dpradovillar/Eli-Batt/Hardware/master/MegaMiniPinoutRef2.pdf

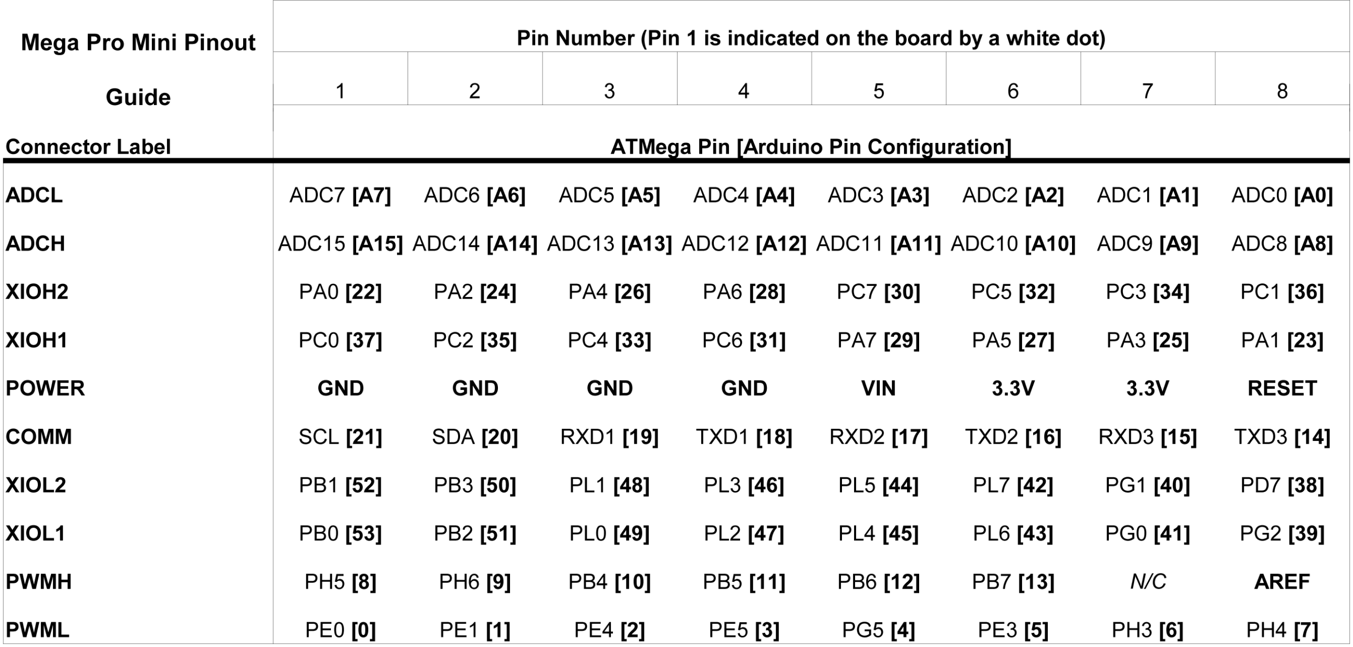
[picture p1: page 1]
