dpradovillar/Eli-Batt/Hardware/master/eagleUp/eagleU01.png

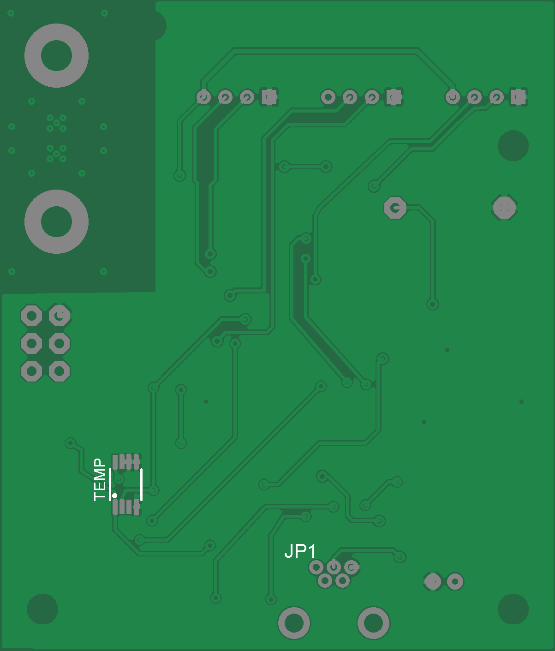
Hardware/master/eagleUp/eagleU01.png
