dpradovillar/Eli-Batt/Hardware/master/eagleUp/eagleUp_.png

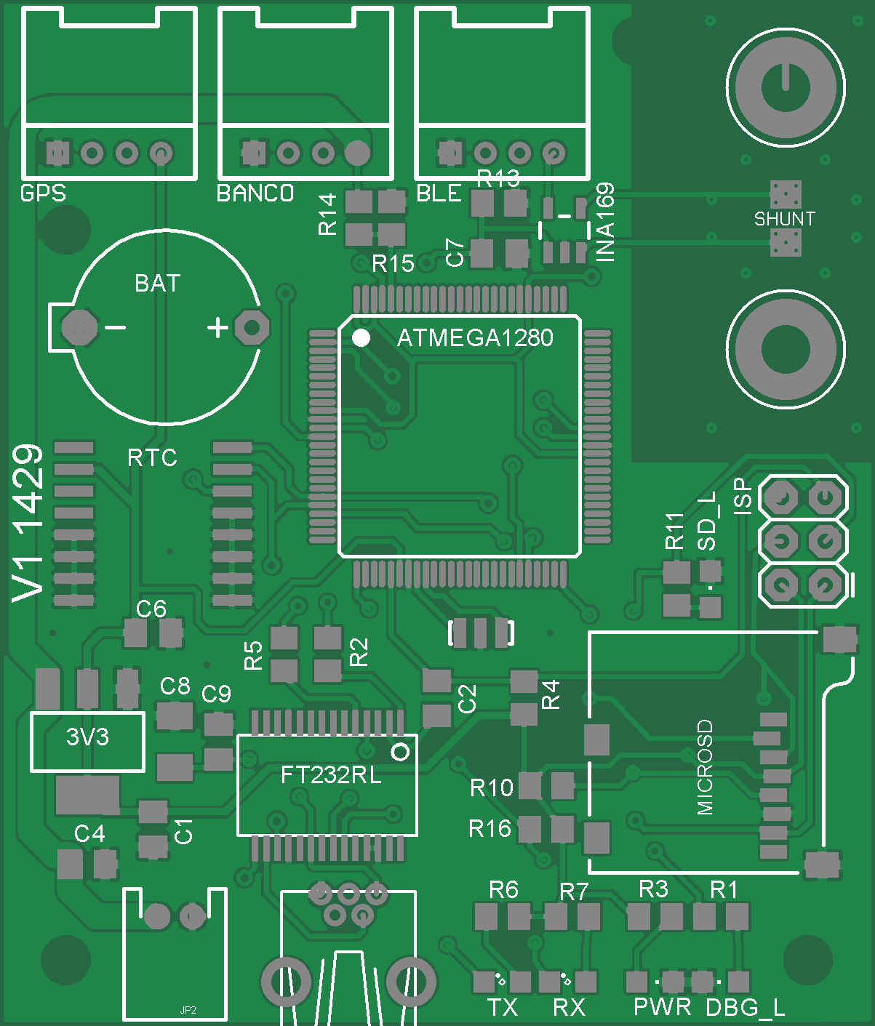
Hardware/master/eagleUp/eagleUp_.png
