dpradovillar/Eli-Batt/Hardware/master/eagleUp/eagleUp_master-v10_board_top.png

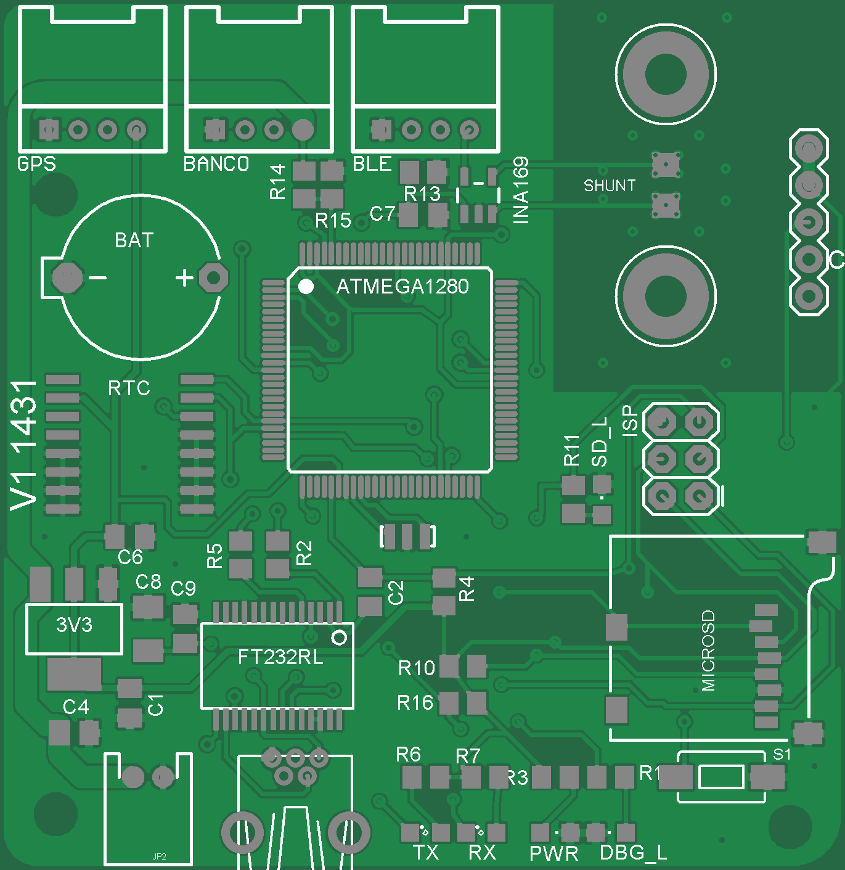
Hardware/master/eagleUp/eagleUp_master-v10_board_top.png
