dpradovillar/Eli-Batt/Hardware/master/eagleUp/eagleUp_master-v10_bottom.png

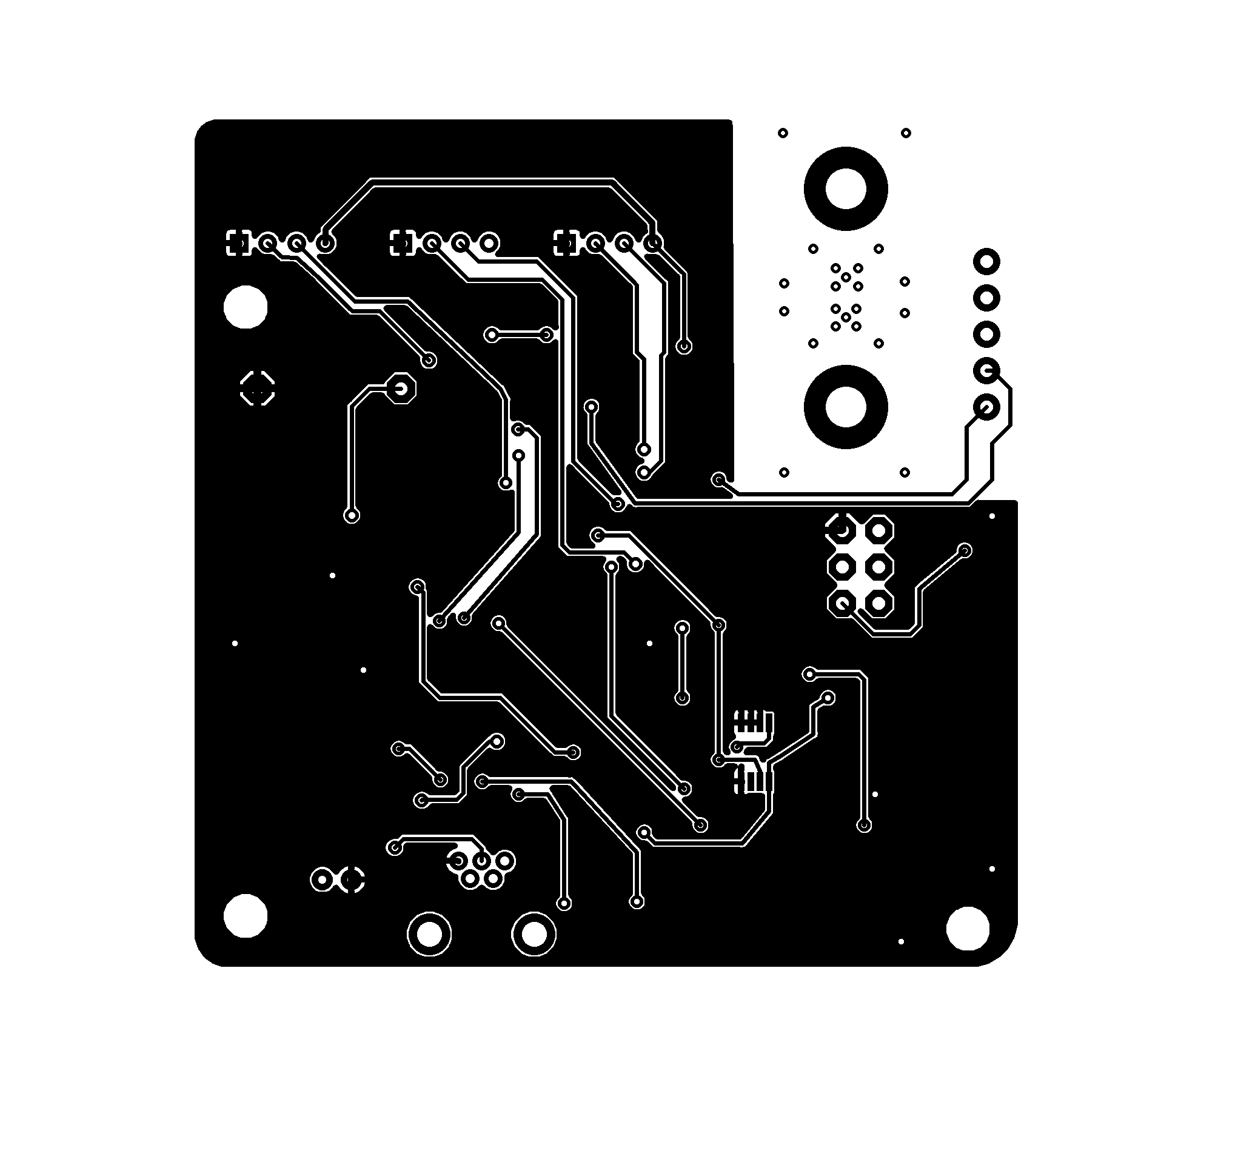
Hardware/master/eagleUp/eagleUp_master-v10_bottom.png
