dpradovillar/Eli-Batt/Hardware/master/eagleUp/eagleUp_master-v10_bottom_mask.png

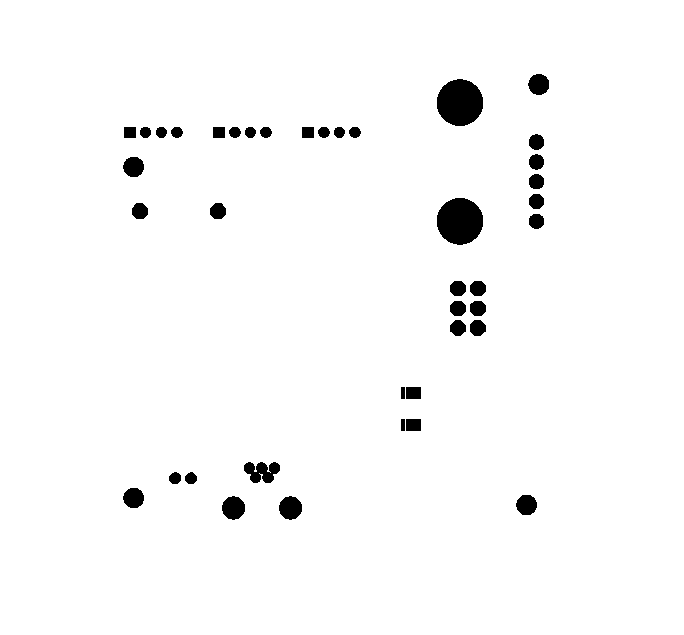
Hardware/master/eagleUp/eagleUp_master-v10_bottom_mask.png
