dpradovillar/Eli-Batt/Hardware/master/eagleUp/eagleUp_master-v10_imagesize.png

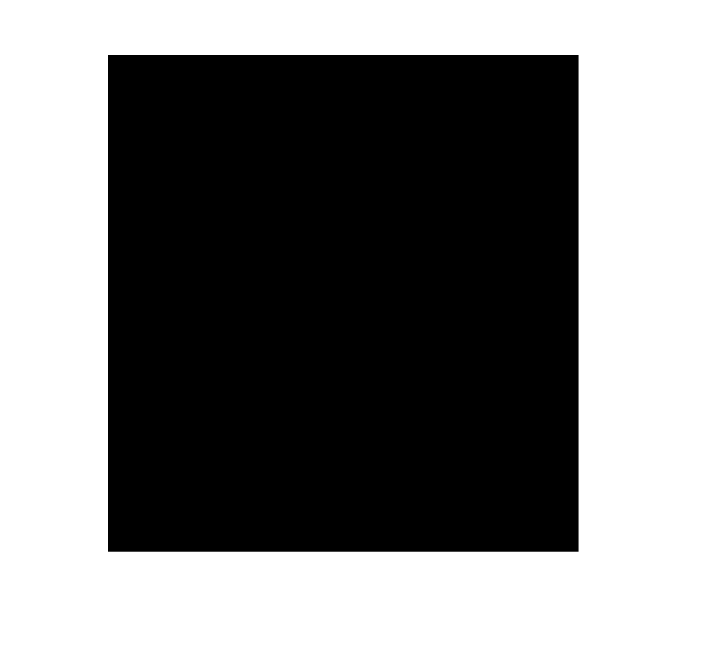
Hardware/master/eagleUp/eagleUp_master-v10_imagesize.png
