dpradovillar/Eli-Batt/Hardware/master/eagleUp/eagleUp_master-v10_outline.png

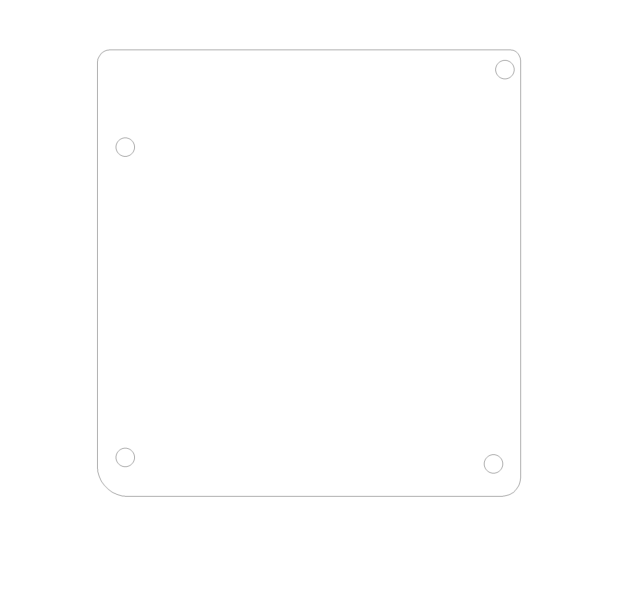
Hardware/master/eagleUp/eagleUp_master-v10_outline.png
