dpradovillar/Eli-Batt/Hardware/master/eagleUp/eagleUp_master-v10_top_mask.png

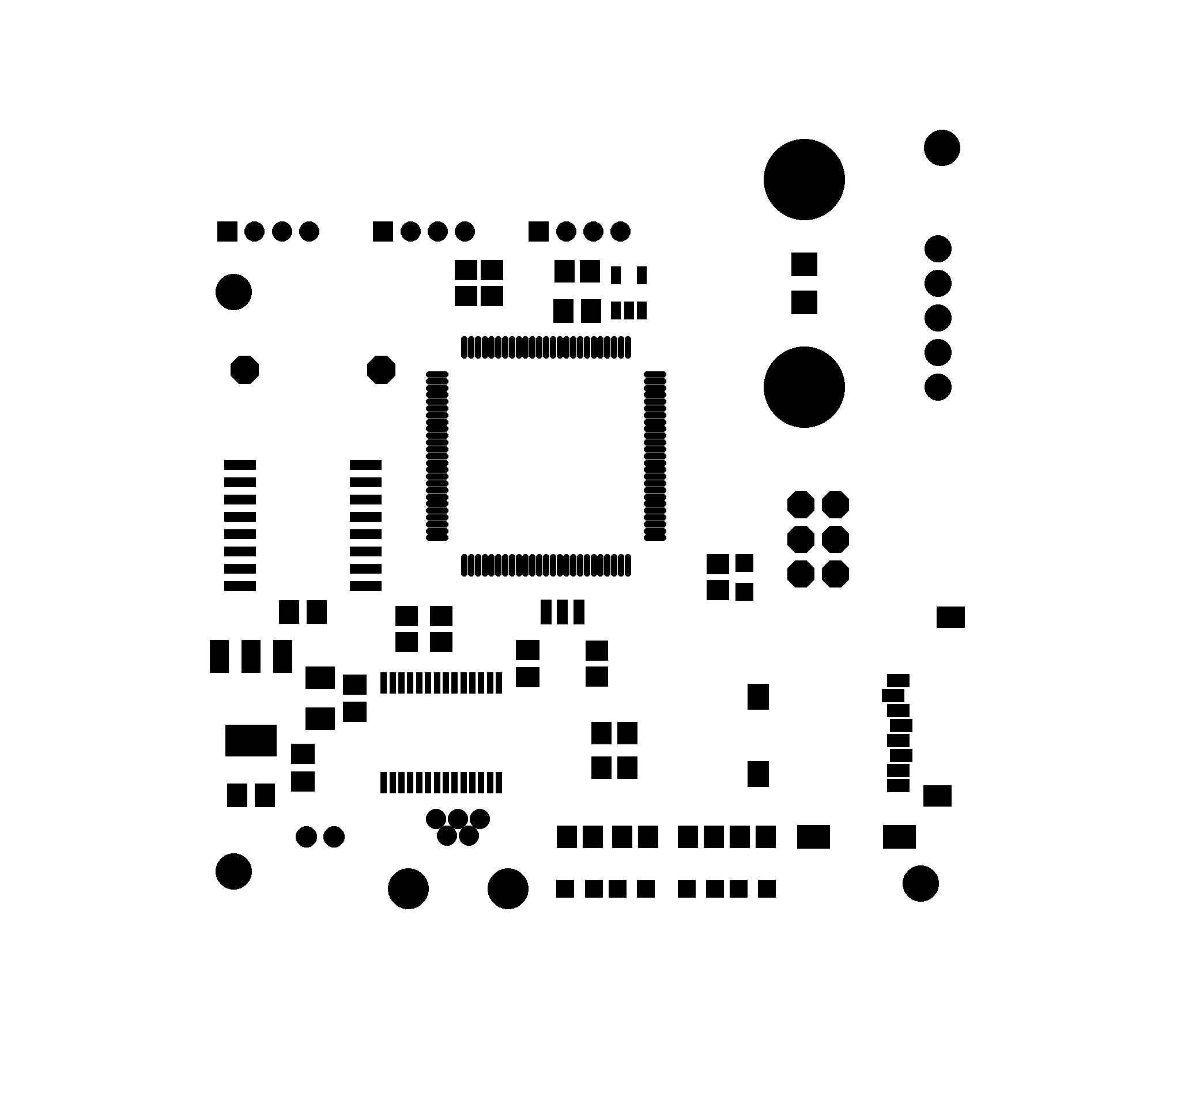
Hardware/master/eagleUp/eagleUp_master-v10_top_mask.png
