dpradovillar/Eli-Batt/Hardware/master/eagleUp/eagleUp_master-v10_top_silk.png

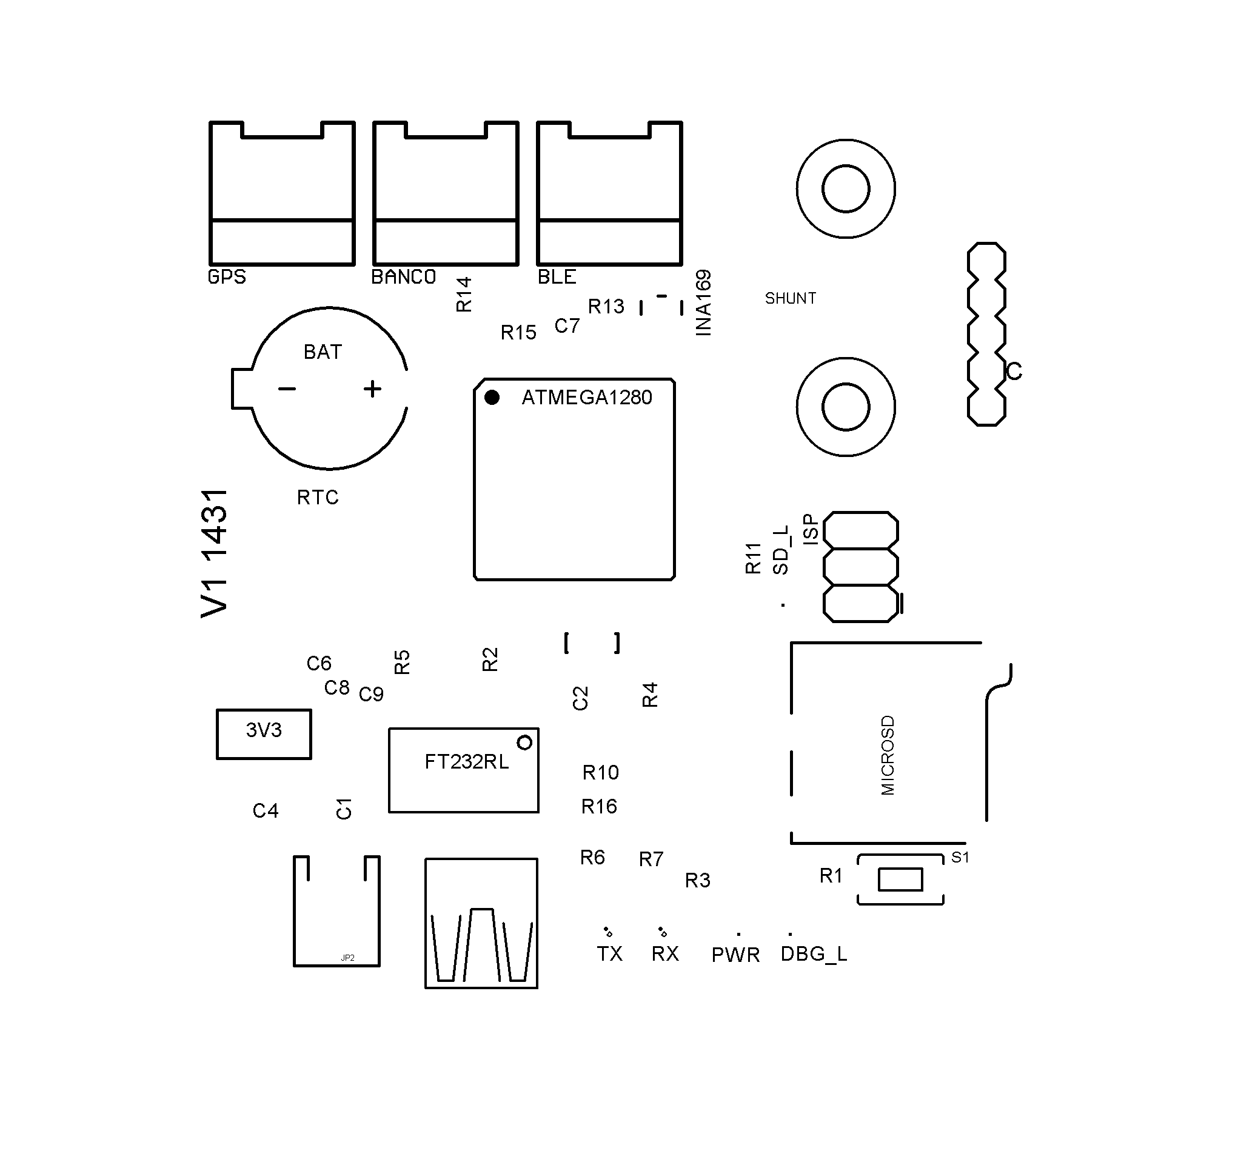
Hardware/master/eagleUp/eagleUp_master-v10_top_silk.png
