dpradovillar/Eli-Batt/Hardware/master/eagleUp/eagleUp_master-v11_board_bottom.png

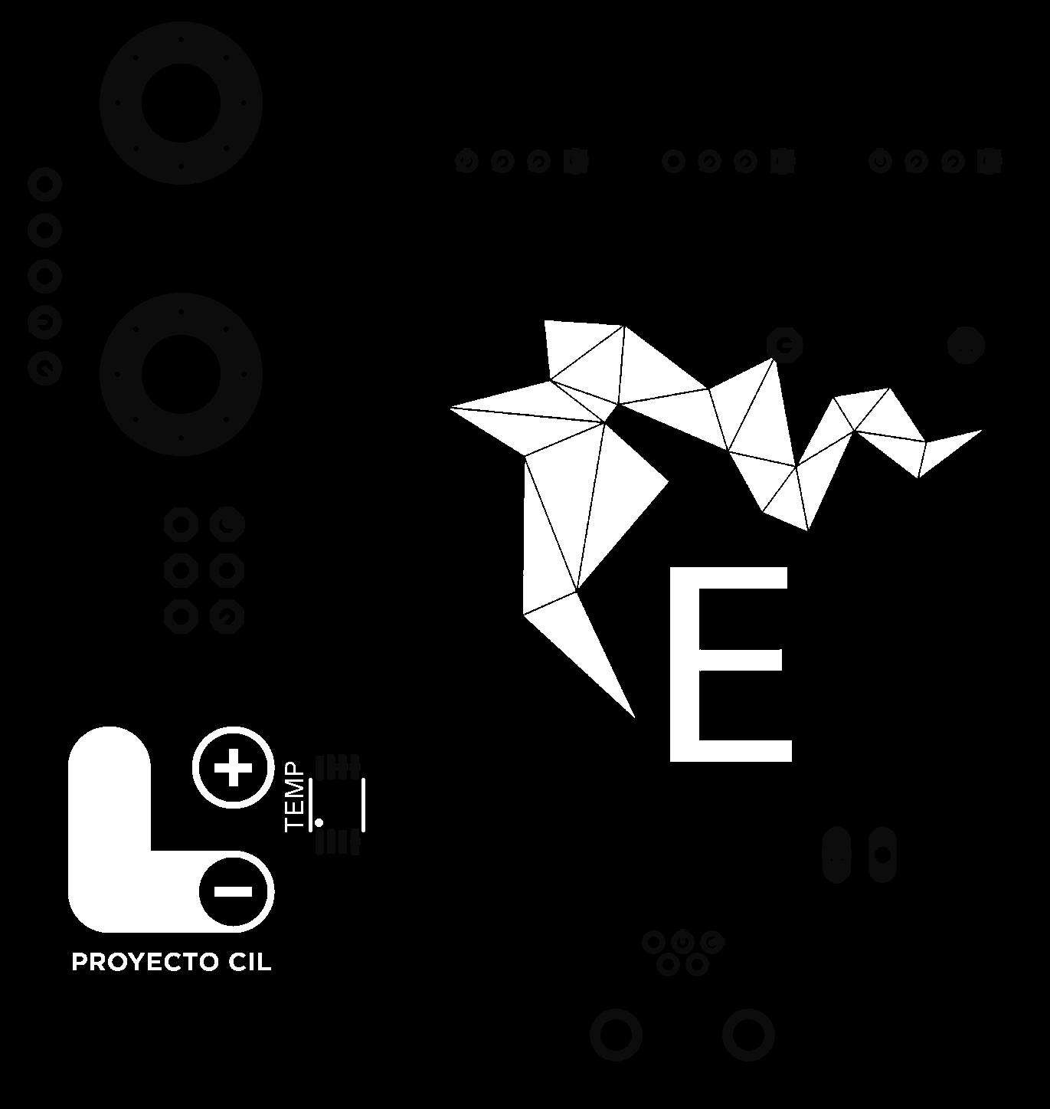
Hardware/master/eagleUp/eagleUp_master-v11_board_bottom.png
