dpradovillar/Eli-Batt/Hardware/master/eagleUp/eagleUp_master-v11_bottom_silk.png

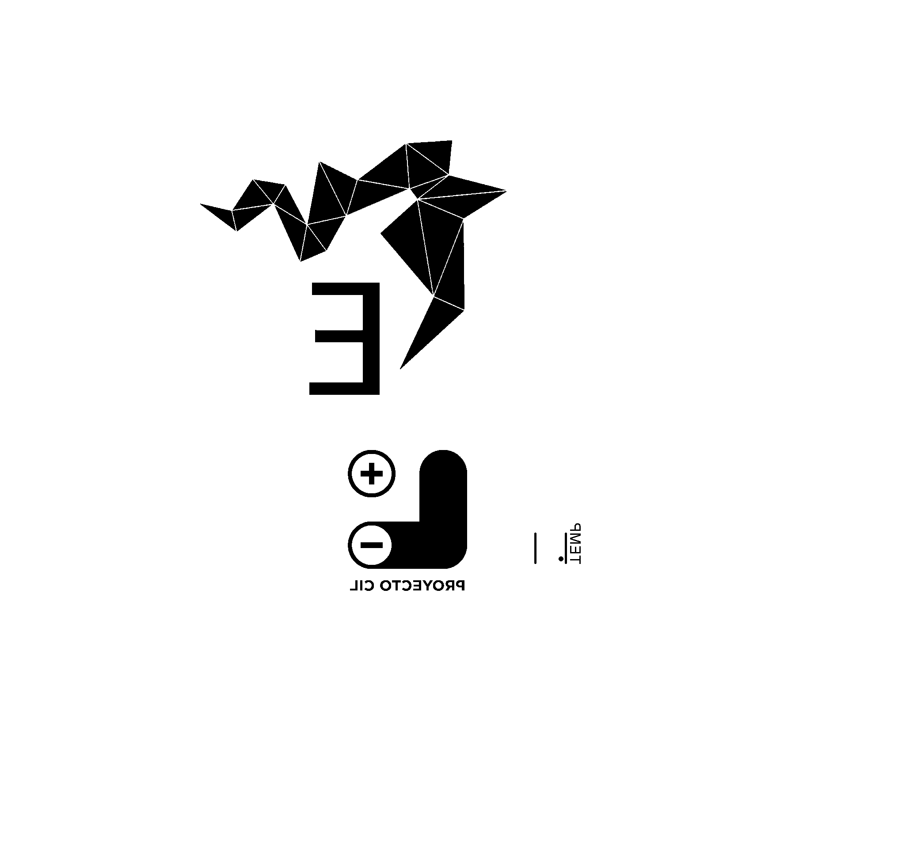
Hardware/master/eagleUp/eagleUp_master-v11_bottom_silk.png
