dpradovillar/Eli-Batt/Hardware/master/eagleUp/eagleUp_master-v11_top.png

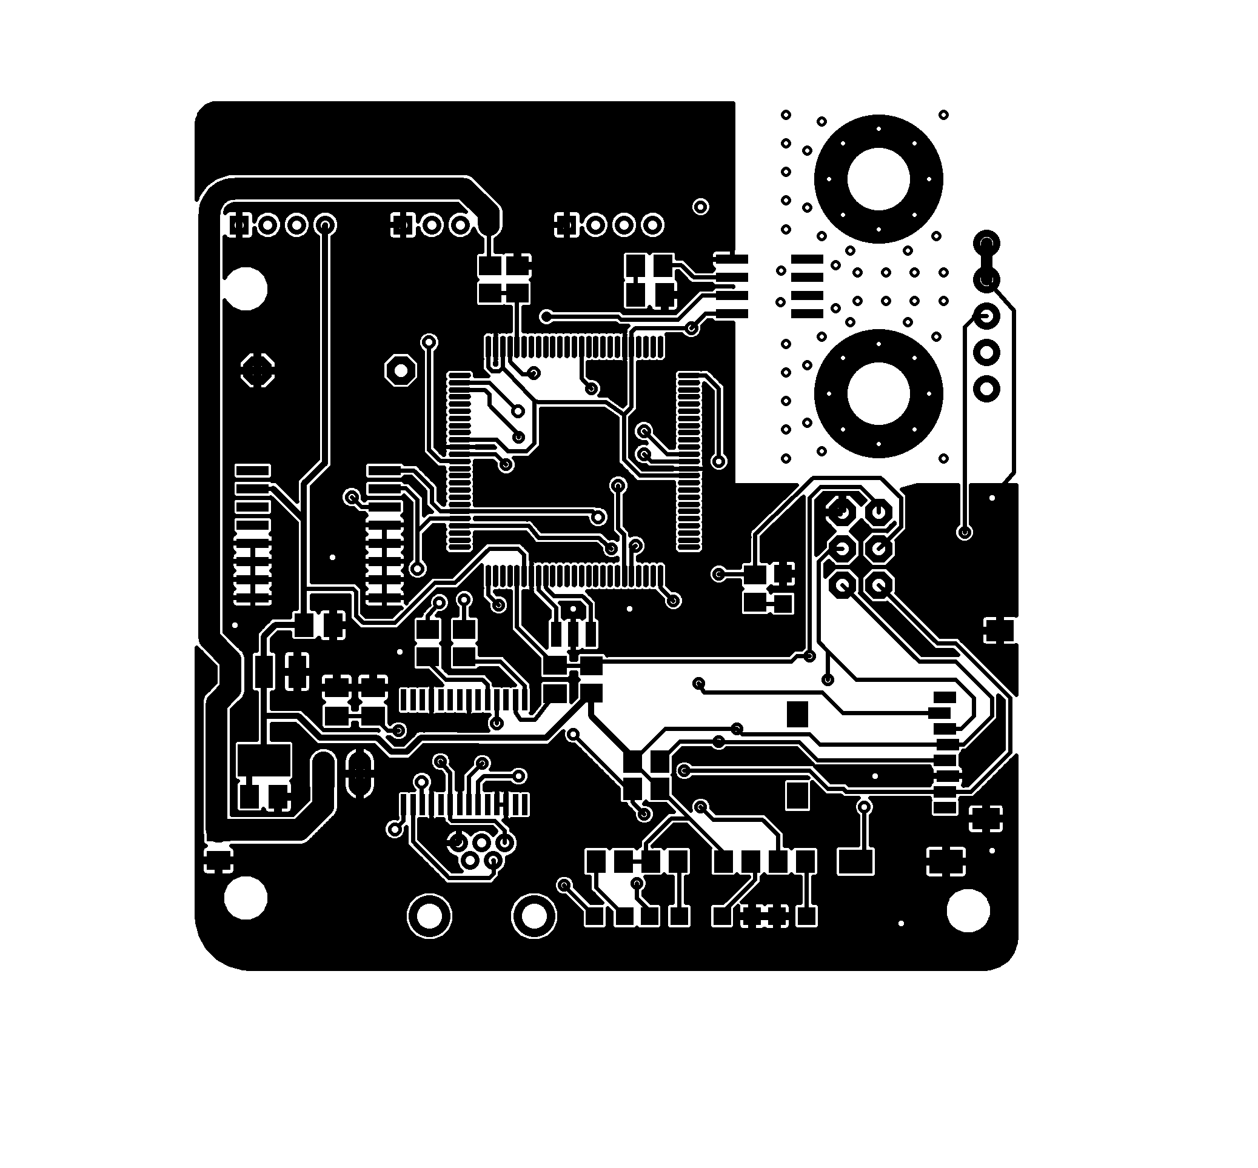
Hardware/master/eagleUp/eagleUp_master-v11_top.png
