dpradovillar/Eli-Batt/Hardware/master/eagleUp/eagleUp_master-v11_top_mask.png

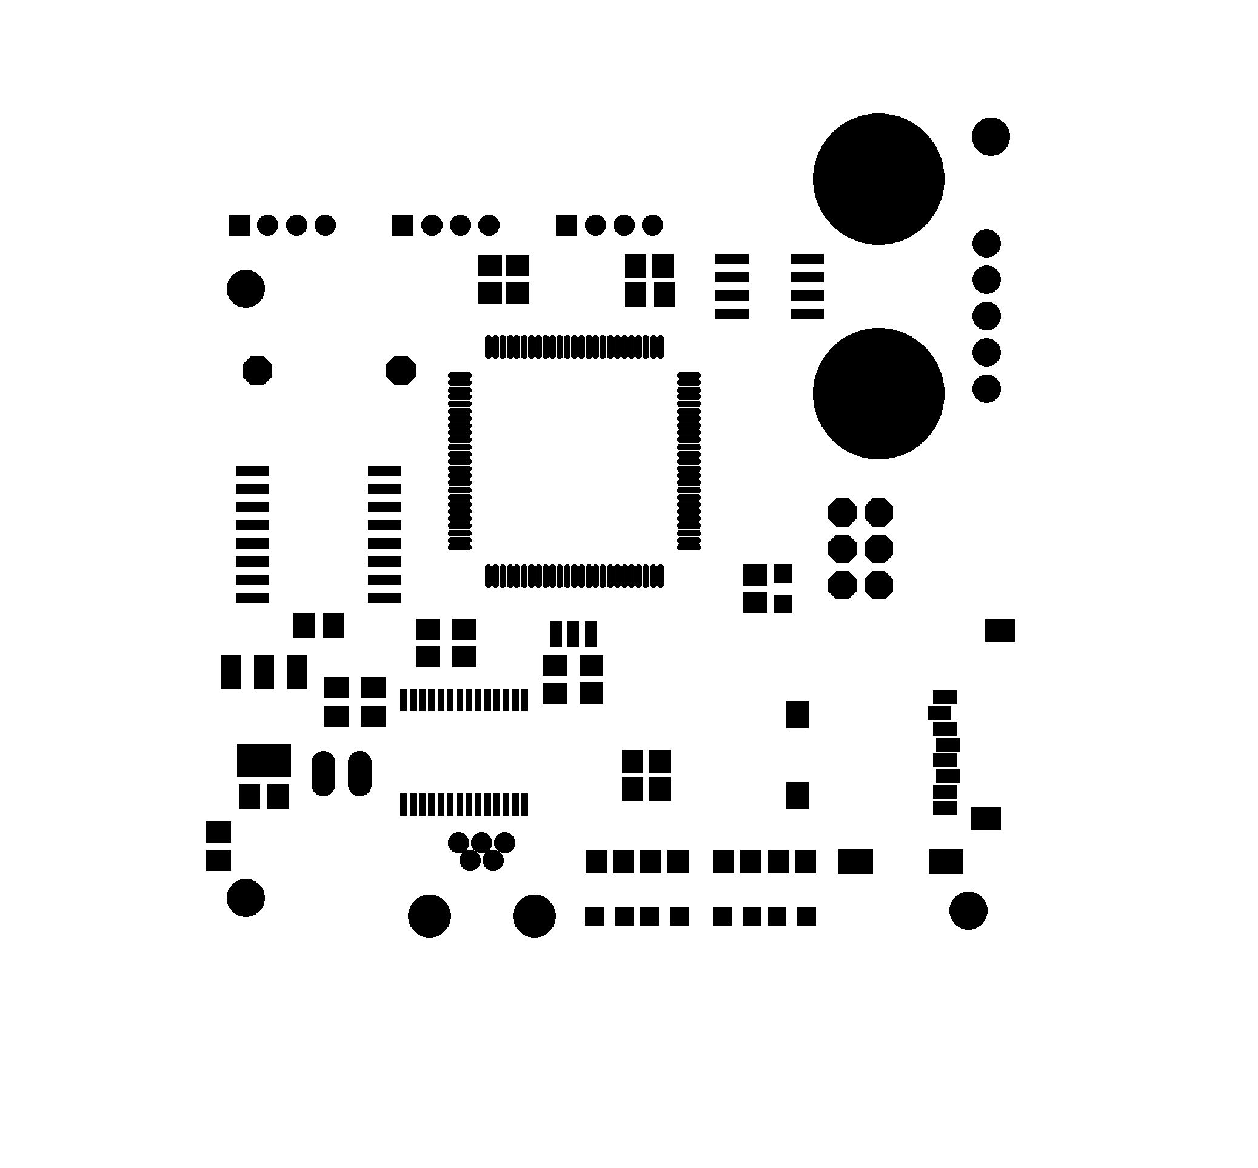
Hardware/master/eagleUp/eagleUp_master-v11_top_mask.png
