dpradovillar/Eli-Batt/Hardware/master/Schematics/ATMEGA1280.jpg

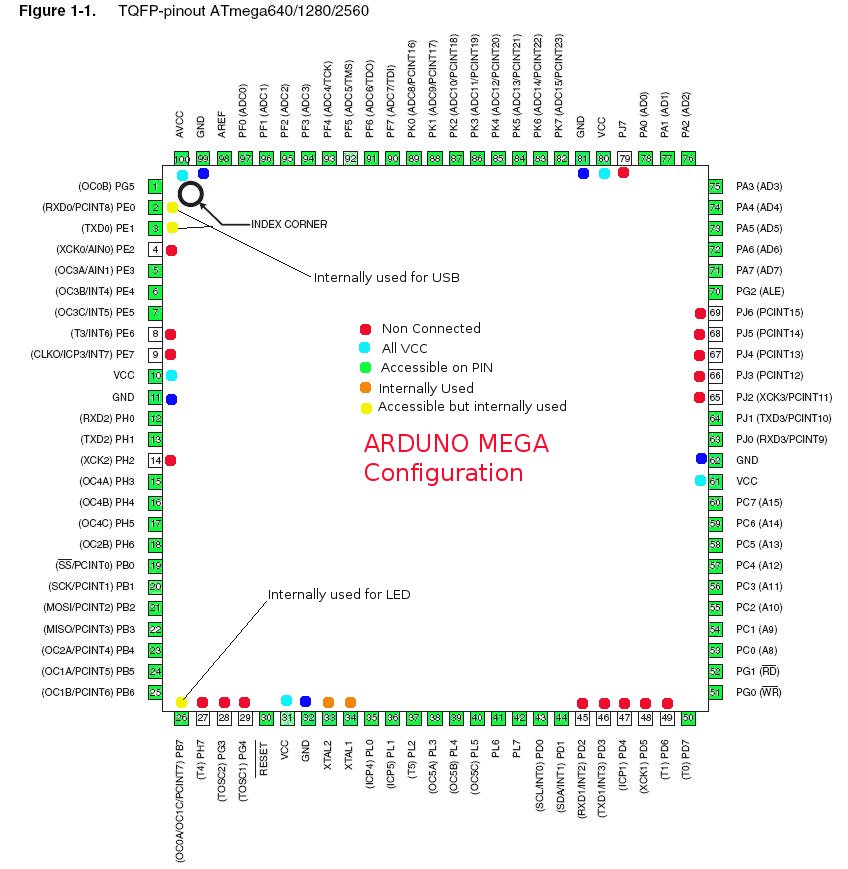
Hardware/master/Schematics/ATMEGA1280.jpg
