dpradovillar/Eli-Batt/Hardware/master/Schematics/Master.png

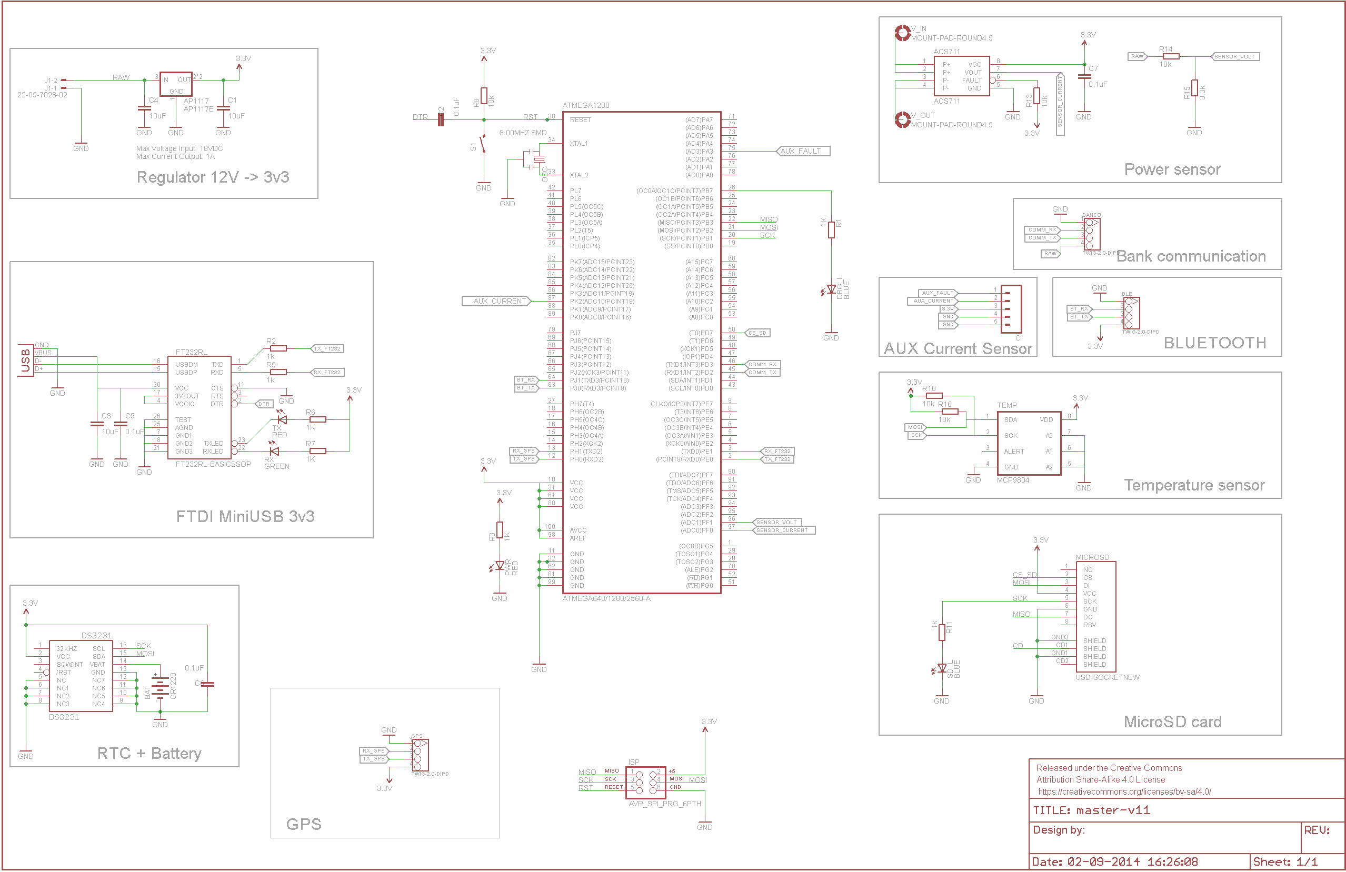
Hardware/master/Schematics/Master.png
