dpradovillar/Eli-Batt/Manufactura/BOM-master-v11.xlsx

Sheet: BOM-master-v11
Qty | Value | Device | Package | Parts | Description | Price | Total Price | Link
4 | 0.1uF | C-EUC0805K | C0805K | C2, C6, C7, C9 | CAPACITOR, European symbol | $0.10 | $0.40 | http://www.digikey.com/product-detail/en/CL21F104ZBCNNNC/1276-1007-1-ND/3889093
4 | 10k | R-EU_R0805 | R0805 | R8, R10, R14, R16 | RESISTOR, European symbol | $0.03 | $0.12 | http://www.digikey.com/product-detail/en/RMCF0805JT10K0/RMCF0805JT10K0CT-ND/1942577
3 | 10uF | C-EUC0805K | C0805K | C1, C3, C4 | CAPACITOR, European symbol | $0.16 | $0.48 | http://www.digikey.com/product-detail/en/CC0805ZKY5V6BB106/311-1355-1-ND/2103139
8 | 1K | R-EU_R0805 | R0805 | R1, R3, R6, R7, R2, R5, R11, R13 | RESISTOR, European symbol | $0.10 | $0.80 | http://www.digikey.com/product-detail/en/RC0805JR-071KL/311-1.0KARCT-ND/731165
1 | J1 | J1 | J1 | J1 | CONN HEADER 2POS .100 R/A TIN | $0.32 | $0.32 | http://www.digikey.com/product-detail/en/0022053021/WM4300-ND/26689
2 | Crimp | Crimp | Crimp | Crimp | CONN TERM CRIMP 22-30 AWG GOLD | $0.64 | $1.28 | http://www.digikey.com/product-detail/en/0008550130/WM9728CT-ND/4037904
1 | Conector | Conector | Conector | Conector | CONN HOUSING 2POS .100 W/RAMP | $0.11 | $0.11 | http://www.digikey.com/product-detail/en/0022012027/WM2011-ND/171991
1 | 3.3k | R-EU_R0805 | R0805 | R15 | RESISTOR, European symbol | $0.63 | $0.63 | http://www.digikey.com/product-detail/en/ERA-6AEB332V/P3.3KDACT-ND/1465959
1 | 8.00MHZ SMD | RESONATOR-SMD | RESONATOR-SMD | OSC | Resonator | $0.46 | $0.46 | http://www.digikey.com/product-detail/en/CSTCE8M00G55-R0/490-1195-1-ND/584632
1 | ACS711 | ACS711 | SOIC8 | ACS711 | Hall-effect-based isolated linear current sensor | $3.05 | $3.05 | http://www.digikey.com/product-detail/en/ACS711KLCTR-25AB-T/620-1373-1-ND/2470587
1 | AP1117E | AP1117E | SOT223 | 3V3 | LDO Regulator | $0.41 | $0.41 | http://www.digikey.com/product-detail/en/AP1117IE33G-13/AP1117IE33G-13DICT-ND/3677984
1 | ATMEGA1280 | ATMEGA1280 | TQFP100A | ATMEGA1280 | MICROCONTROLLER | $15.68 | $15.68 | http://www.digikey.com/product-detail/en/ATMEGA1280-16AUR/ATMEGA1280-16AURCT-ND/3789418
2 | BLUE | LEDCHIPLED_0805 | CHIPLED_0805 | DBG_L, SD_L | LED | $0.44 | $0.88 | http://www.digikey.com/product-detail/en/LTST-C171TBKT/160-1645-1-ND/573585
1 | CR1220 | CR1220 | CR1220 | BAT | LI BATTERY Panasonic | $1.20 | $1.20 | http://www.digikey.com/product-detail/en/CR-1220%2FHFN/P244-ND/965114
1 | DS3231/SO | DS3231 | SO16W | RTC |  | $8.41 | $8.41 | http://www.digikey.com/product-detail/en/DS3231SN%23T%26R/DS3231SN%23T%26RCT-ND/3894827
1 | FT232RL-BASICSSOP | FT232RL | SSOP28DB | FT232RL | USB UART | $4.50 | $4.50 | http://www.digikey.com/product-detail/en/FT232RL-REEL/768-1007-1-ND/1836402
1 | GREEN | LEDCHIPLED_0805 | CHIPLED_0805 | RX | LED | $0.08 | $0.08 | http://www.digikey.com/product-detail/en/LG%20R971-KN-1/475-1410-1-ND/1802598
1 | MCP9804 | MCP9804 | MSOP8 | TEMP | TEMP SENSOR | $1.36 | $1.36 | http://www.digikey.com/product-detail/en/MCP9808-E%2FMS/MCP9808-E%2FMS-ND/2802083
2 | RED | LEDCHIPLED_0805 | CHIPLED_0805 | PWR, TX | LED | $0.08 | $0.16 | http://www.digikey.com/product-detail/en/LH%20R974-LP-1/475-1415-1-ND/1802604
1 | MOMENTARY-2-SMD | SWITCH | TACTILE-SWITCH-1101NE | S1 | Various NO switches- pushbuttons, reed, etc | $0.07 | $0.07 | http://imall.iteadstudio.com/electronic-components/button-and-switch/im120731002.html
3 | TWIG-2.0-DIPD | TWIG-2.0-DIPD | 2.0_1X4_90 | BANCO, BLE, GPS |  | $0.10 | $0.30 | http://www.seeedstudio.com/depot/Grove-Universal-4-pin-connector-9010-PCs-p-790.html
1 | USB-MB-H | USB-MB-H | USB-MB-H | JP1 | USB Connectors | $2.28 | $2.28 | http://www.digikey.com/product-detail/en/0565790519/WM17121-ND/857607
1 | USD-SOCKETNEW | USD-SOCKETNEW | MICRO-SD-SOCKET-PP | MICROSD | microSD Socket | $1.82 | $1.82 | http://www.digikey.com/product-detail/en/101-00660-68-6/101-00660-68-6-1-ND/2187099
 |  |  |  |  |  | TOTAL | $44.80

Sheet: CIL stock
Qty | Value | Device | Package | Parts | Description | Price | Total Price | Link
16 |  | SOC |  |  | SOC RV1.1
6 |  | 4 pin connector |  |  | Grove-Universal 4Pin 90°
1 |  | BLE |  |  | Bluetooth smart 4.0 Mini
5 |  | GPS |  |  | Crius Neo-6 GPS
1 |  | GPS |  |  | g.top013
2 |  | USB Bluetooth dongle |  |  | USB Bluetooth dongle
6 |  | 4 pin connector |  |  | Grove-Universal 4Pin
1 |  | AVR Programer |  |  | Pocket AVR Programer
2 |  | Temp Sensor |  |  | TEMP SENSOR MCP9808-40 a +125°C
2 |  | RTC |  |  | RTC ChronoDot V2.1
3 |  | Mini USB Breakout |  |  | Mini USB Breakout Sparkfun
2 |  | Micro SD Breakout Boeard |  |  | Micro SD Breakout Boeard Sparkfun
2 |  | Microcontroller Mega Pro |  |  | Atmega 2560V Shield
18 |  | Pulsadores |  |  | 6 Pin- Pulsadores
16 |  | 2Pin Screw terminal block |  |  | 2Pin Screw terminal block 3.5mm
7 |  | Current sensor |  |  | ACS711EX -15.5 a +15.5 Amps (Item 2452)
2 |  | Current sensor |  |  | ACS709 -75 a +75 Amps (Item 2199)
5 |  | Microcontroller ATMega 328 |  |  | Microcontroller ATMega 328 bootloader UNO
3 |  | Battery CR 1220 |  |  | Lithium Coin 3V CR-1220
2 |  | Switch |  |  | 6.5 A / 250V
3 |  | Switch Tactile |  |  | Switch Tactile 0.05A / 12V
12 |  | Capacitor |  |  | Cap. Cer. 0.1 Uf 50V 0805
10 |  | Capacitor |  |  | Cap. Cer. 10 Uf 50V 0805
3 |  | Current sensor |  |  | ACS711 25 Amps
3 |  | 3.3V LDO Regulator |  |  | AP1117E
3 |  | Microcontroller ATMega 1280 |  |  | Microcontroller ATMega 1280 128KB flash 100TQFP
3 |  | RTC |  |  | IC RTC CLK/Calendar 12C 16-SOIC DS3231
3 |  | FT232RL |  |  | USB FS serial UART 28-SSOP
6 |  | LED Blue |  |  | Blue LED 0805
3 |  | LED Green |  |  | Green LED 0805
6 |  | LED Red |  |  | Red LED 0805
3 |  | Antena GPS |  |  | Cab. 718 20cm
1 |  | Antena GPS |  |  | Cab. 011 10cm
3 |  | Conn Header |  |  | Conn Header 2 pos. R/A tin
3 |  | Conn USB |  |  | Conn USB 5 pos
3 |  | Conn Micro SD |  |  | Conn Micro SD 8 pin PCB Gold
3 |  | Resonator |  |  | Cer. Resonator 8Mhz SMD
35 |  | Resistors |  |  | Res. 1K ohm 1/8W 0805
12 |  | Resistors |  |  | Res. 10K ohm 1/8W 0805
19 |  | Resistors |  |  | Res. 3.3K ohm 1/8W 0805
2 |  | porta fusible
11 |  | cables |  |  | 8 pin fem.
