dpradovillar/Eli-Batt/Hardware/master/Schematics/Leonardino_parts_list.xls

Atmega32U4_H49xtal_uSD_RevA.5.sch |  | Manufacturer P/N | Digikey PN
Part Value Device Package Library Sheet
+3V +3V SJ SJ jumper 1
C1 22p C-EUC0805K C0805K rcl 1 | 22pFnF, 0805 | GRM2195C2A220JZ01D | 490-1591-2-ND
C10 100n C-EUC0805K C0805K rcl 1 | 100nF, 0805 | C0805C104K3RACTU | 399-1168-1-ND
C11 100n C-EUC0805K C0805K rcl 1 | 100nF, 0805 | C0805C104K3RACTU | 399-1168-1-ND
C3 22p C-EUC0805K C0805K rcl 1 | 22pFF, 0805 | GRM2195C2A220JZ01D | 490-1591-2-ND
C4 100n C-EUC0805K C0805K rcl 1 | 100nF, 0805 | C0805C104K3RACTU | 399-1168-1-ND
C5 100n C-EUC0805K C0805K rcl 1 | 100nF, 0805 | C0805C104K3RACTU | 399-1168-1-ND
C6 100n C-EUC0805K C0805K rcl 1 | 100nF, 0805 | C0805C104K3RACTU | 399-1168-1-ND
C12 1uF C-EUC0805K C0805K rcl 1 | 1uF, 0805 | GRM216R61E105KA12D | 490-1700-2-ND
C2 1uF C-EUC0805K C0805K rcl 1 | 1uF, 0805 | GRM216R61E105KA12D | 490-1700-2-ND
C7 1uF C-EUC0805K C0805K rcl 1 | 1uF, 0805 | GRM216R61E105KA12D | 490-1700-2-ND
C8 1uF C-EUC0805K C0805K rcl 1 | 1uF, 0805 | GRM216R61E105KA12D | 490-1700-2-ND
C9 1uF C-EUC0805K C0805K rcl 1 | 1uF, 0805 | GRM216R61E105KA12D | 490-1700-2-ND
F1 500mA L-EUL1812 L1812 rcl 1 | polyfuse | 1812L075PR | F2151CT-ND
IC1 MCP1703DB MCP1703DB SOT223 linear 1 | MCP1703DB | MCP1703-3302E/DB | MCP1703-3302E/DB-ND
IC4 SN74LVC125ADR SN74LVC125ADR TSSOP14 74xx-us 1 | SN74LVC125ADR | SN74LVC125ADR | 296-8453-1-ND
JP1 M06SIP 1X06 SparkFun 1 | 0.025", 0.1" pitch header pins
JP3 M06SIP 1X06 SparkFun 1 | header pins
JP4 M06SIP 1X06 SparkFun 1 | header pins
JP6 M06SIP 1X06 SparkFun 1 | header pins
JP7 M03PTH 1X03 SparkFun 1 | header pins
JP8 M03PTH 1X03 SparkFun 1 | header pins
JP9 M03PTH 1X03 SparkFun 1 | header pins
JP10 M03PTH 1X03 SparkFun 1 | header pins
VBUS M02PTH 1X02 SparkFun 1 | header pins
VBUS_ M02PTH 1X02 SparkFun 1 | header pins
0.1" x 2 Jumper | qty 2 | 382811-8 | A26228-ND
PWR LEDCHIP-LED0805 CHIP-LED0805 adafruit 1 | LED, 0805 | LG R971-KN-1-0-20-R18 | 475-1410-1-ND
Q1 CRYSTALHC49UP HC49UP crystal 1 | HC49UP, 16 MHz | 9C-16.000MEEJ-T | 887-1274-1-ND
R1 1K R-EU_ R0805RND rcl 1 | 1K, 0805 | RR1220P-102-D | RR12P1.0KDCT-ND
R2 22 R-EU_ R0805RND rcl 1 | 22 ohm, 08085 | RR1220Q-220-D | RR12Q22DCT-ND
R3 22 R-EU_ R0805RND rcl 1 | 22 ohm, 08085 | RR1220Q-220-D | RR12Q22DCT-ND
R4 10k R-EU_ R0805RND rcl 1 | 10K, 0805 | RR1220P-103-D | RR12P10.0KDCT-ND
R5 10k R-EU_ R0805RND rcl 1 | 10K, 0805 | RR1220P-103-D | RR12P10.0KDCT-ND
U4 ATMEGA32U4-AU ATMEGA32U4-AU TQFP44 adafruit 1 | ATMEGA32U4 | ATMEGA32U4-AU | ATMEGA32U4-AU-ND
USD MICROSD_PI MICROSD_PP MICROSD_PITO 1 | MicroSD socket, SM | http://www.dipmicro.com/store/CON-MICROSD1
 |  | MicroSD/TransFlash push/push connector.
X1 USB-MICROB USB-MICROB USB-MICROB SparkFun 1 | Mini-B socket, 5 pin, SM | 1981568-1 | A97800CT-ND
 |  | TE Connectivity
