dpradovillar/Eli-Batt/(list of files, cad)

Other CAD files:
Hardware/master/eagleUp/PCB MASTER Black.skp
Hardware/master/eagleUp/PCB MASTER.skp
