dpradovillar/Eli-Batt/Manufactura/Assembling_reference.jpg

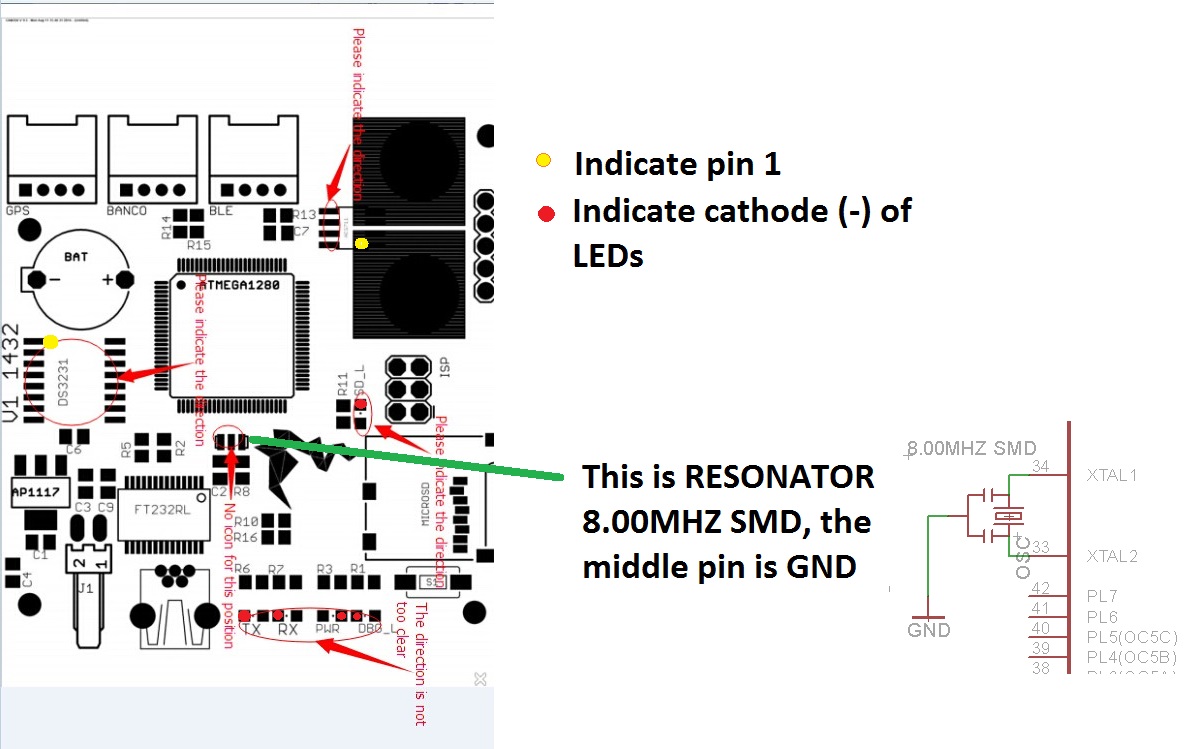
Manufactura/Assembling_reference.jpg
