dpradovillar/Eli-Batt/Software/Elibatt-Viewer/data/data.pdf

# Reporte E-LiBatt

## Temperatura (C°)

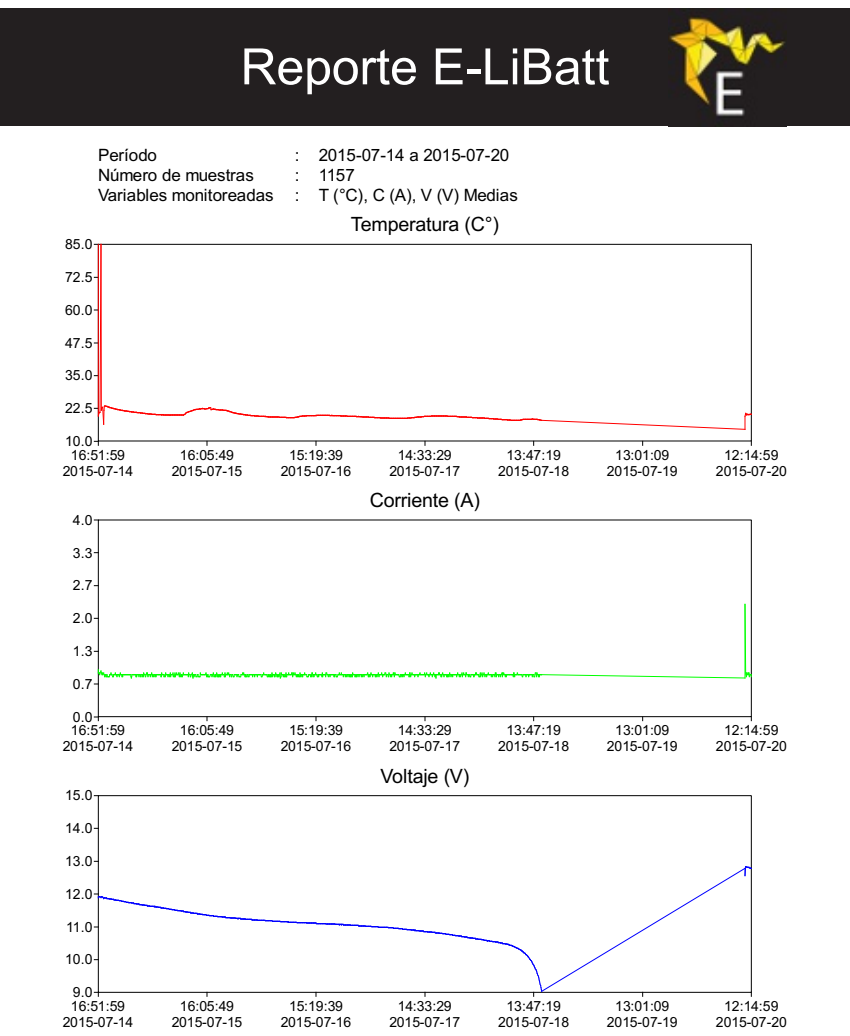
[picture p44: page 1]
2015-07-14 a 2015-07-20 1157 T (°C), C (A), V (V) Medias; Corriente (A); Voltaje (V)

Período
Número de muestras
Variables monitoreadas
