dpradovillar/Eli-Batt/Hardware/slave/Slave-v12.brd

## EAGLE design Hardware/slave/Slave-v12.brd (2015-03-27)

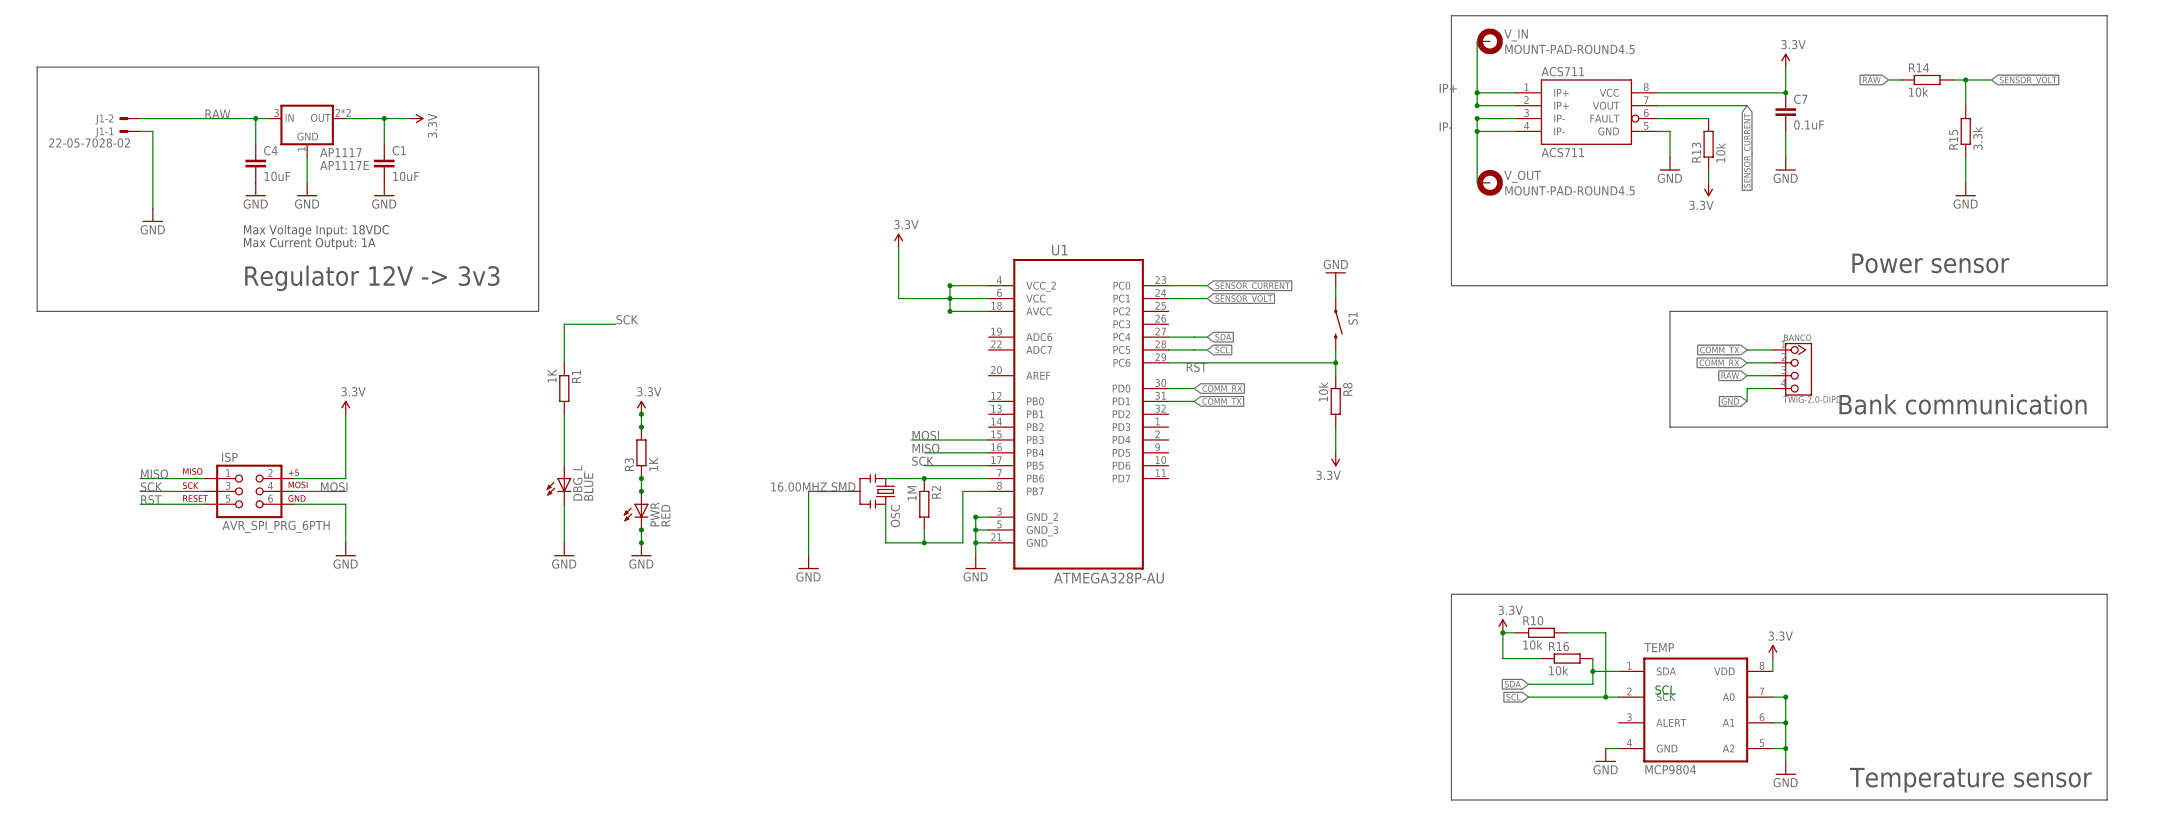
[picture p45: schematic Slave-v12.sch]

Parts:
ACS711: ACS711; SOIC8; MPN ACS711KLCTR-25AB-T
AP1117: AP1117E; SOT223; MPN AP1117E33G-13
BANCO: TWIG-2.0-DIPD; 2.0_1X4_90
C1, C4: 10uF; C0805K; MPN 0805ZD106KAT2A
C7: 0.1uF; C0805K; MPN MC0603B104K500CT
DBG_L: BLUE; CHIPLED_0805; MPN 150080BS75000
ISP: AVR_SPI_PRG_6PTH; 2X3
J1: 22-05-7028-02; 7395-02
OSC: 16.00MHZ SMD; RESONATOR-SMD; MPN PBRC8.00HR50X000
PWR: RED; CHIPLED_0805; MPN KPT-2012SRC-J4
R1, R3: 1K; R0805; MPN CRCW08051K00FKTA
R2: 1M; R0805; MPN CRCW080510K0FKTA
R8, R10, R13, R14, R16: 10k; R0805; MPN CRCW080510K0FKTA
R15: 3.3k; R0805; MPN CRCW08053K30FKTA
S1: SWITCH-MOMENTARY-2-SMD-1101NE; TACTILE-SWITCH-1101NE
TEMP: MCP9804; MSOP8; MPN MCP9808-E/MS
U1: ATMEGA328P-AU; QFP80P900X900X120-32N
V_IN: MOUNT-PAD-ROUND4.5; 4,5-PAD
V_OUT: MOUNT-PAD-ROUND4.5; 4,5-PAD

Connections:
3.3V: ACS711.8 (VCC), C7.1, ISP.2, R3.2, R8.2, R10.1, R13.1, R16.1, TEMP.8 (VDD), U1.4 (VCC_2), U1.6 (VCC), U1.18 (AVCC)
COMM_RX: BANCO.2, U1.30 (PD0)
COMM_TX: BANCO.1, U1.31 (PD1)
GND: ACS711.5 (GND), AP1117.1 (GND), BANCO.4, C1.2, C4.2, C7.2, DBG_L.C, ISP.6, J1.1, OSC.2, PWR.C, R15.1, S1.P$1 (1), TEMP.4 (GND), TEMP.5 (A2), TEMP.6 (A1), TEMP.7 (A0), U1.3 (GND_2), U1.5 (GND_3), U1.21 (GND)
IP+: ACS711.1 (IP+), ACS711.2 (IP+), V_IN.B4,5
IP-: ACS711.3 (IP-), ACS711.4 (IP-), V_OUT.B4,5
MISO: ISP.1, U1.16 (PB4)
MOSI: ISP.4, U1.15 (PB3)
unnamed: OSC.1, R2.1, U1.7 (PB6)
unnamed: DBG_L.A, R1.2
unnamed: PWR.A, R3.1
unnamed: OSC.3, R2.2, U1.8 (PB7)
unnamed: ACS711.6 (FAULT), R13.2
RAW: AP1117.3 (IN), BANCO.3, C4.1, J1.2, R14.1
RST: ISP.5, R8.1, S1.P$2 (2), U1.29 (PC6)
SCK: ISP.3, R1.1, U1.17 (PB5)
SCL: R10.2, TEMP.2 (SCK), U1.28 (PC5)
SDA: R16.2, TEMP.1 (SDA), U1.27 (PC4)
SENSOR_CURRENT: ACS711.7 (VOUT), U1.23 (PC0)
SENSOR_VOLT: R14.2, R15.2, U1.24 (PC1)
VCC: AP1117.2 (OUT), AP1117.4 (OUT), C1.1

Notes on the sheet:
Max Voltage Input: 18VDC
Max Current Output: 1A
Regulator 12V -> 3v3
Power sensor
Temperature sensor
Bank communication
SCL

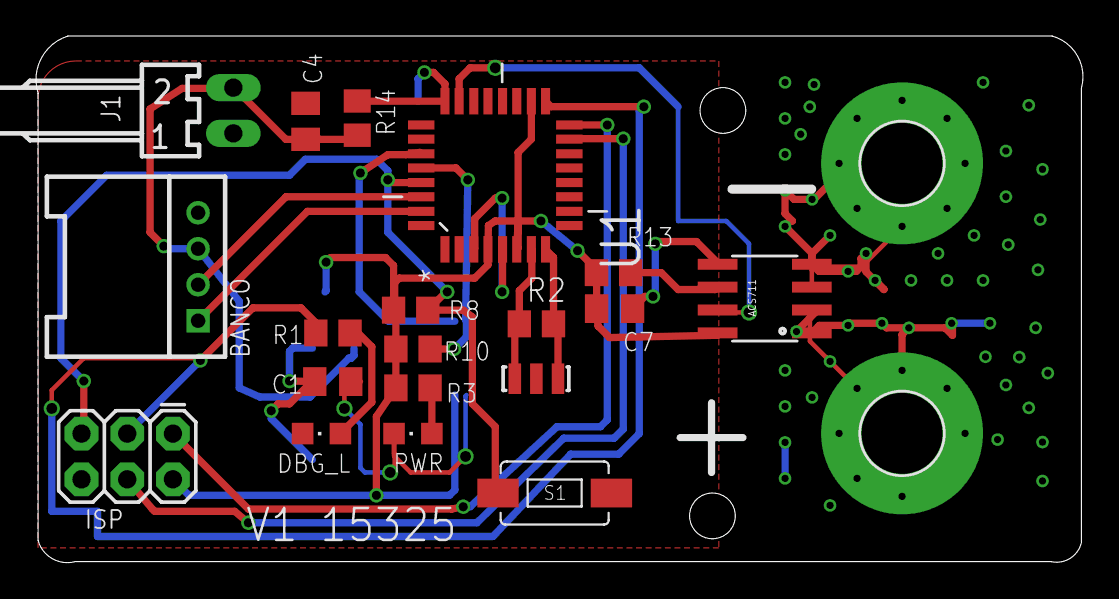
[picture p46: board Slave-v12.brd from above]

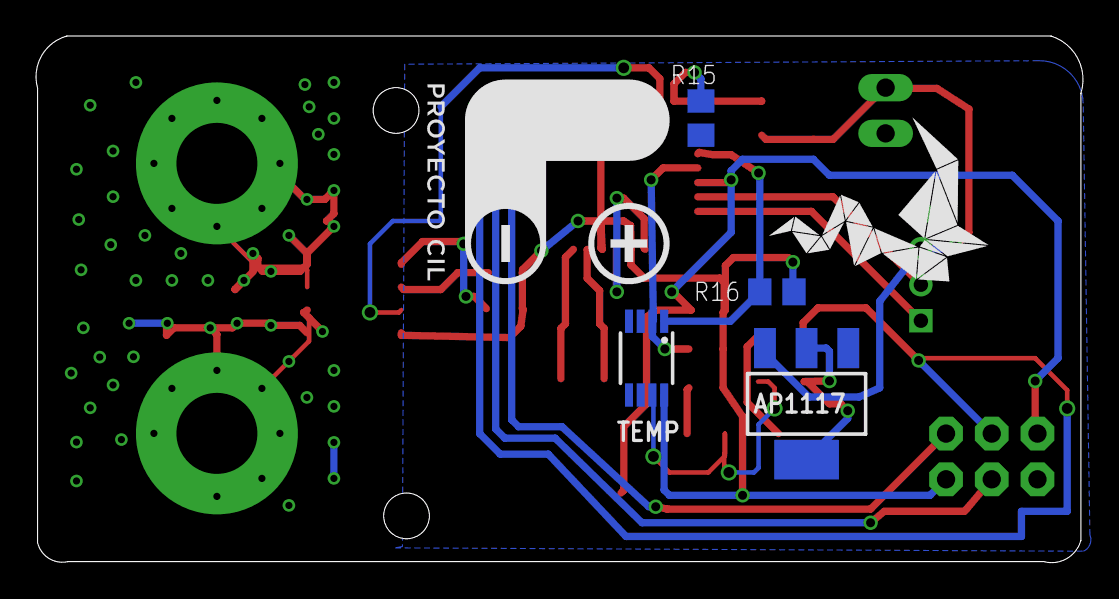
[picture p47: board Slave-v12.brd from below]

Board: 2 copper layers, 58.2 x 29.3 mm, 27 parts (6 on the bottom side), 21 nets.

Other parts of the board:
U$1: LOGO_CIL
U$4: LOGO_ELIBATT2
