dpradovillar/Eli-Batt/Hardware/master/master-v12_36V.brd

## EAGLE design Hardware/master/master-v12_36V.brd (2014-12-18)

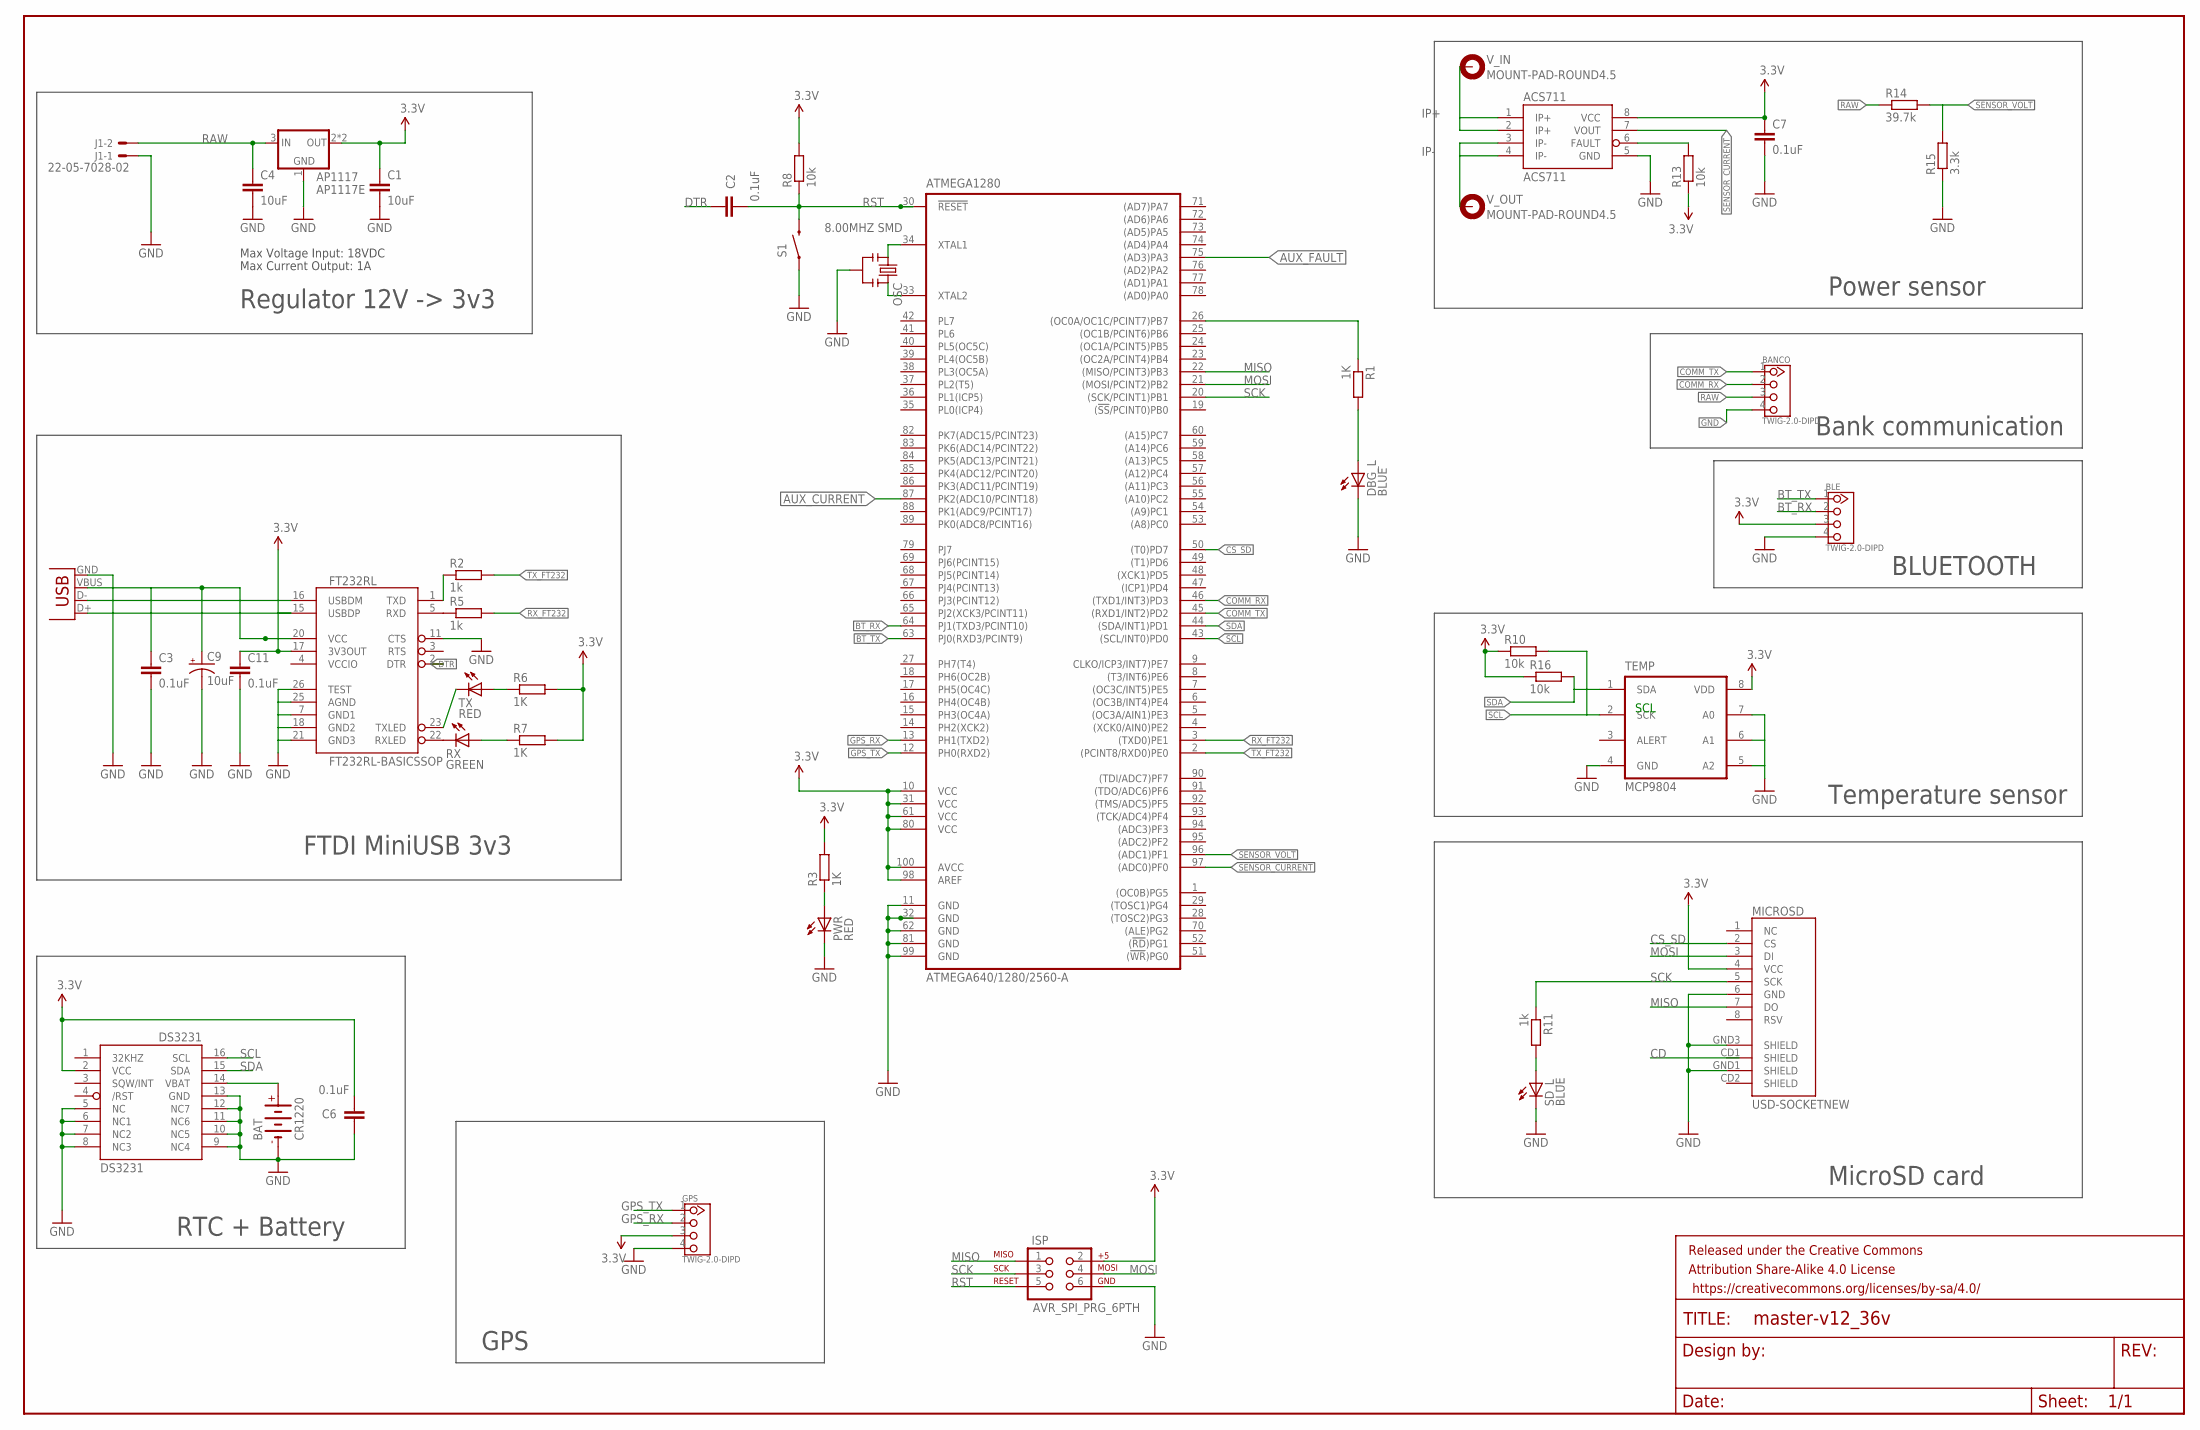
[picture p48: schematic master-v12_36V.sch]

Parts:
ACS711: ACS711; SOIC8
AP1117: AP1117E; SOT223
ATMEGA1280: ATMEGA640/1280/2560-A; TQFP100A
BANCO: TWIG-2.0-DIPD; 2.0_1X4_90
BAT: CR1220
BLE: TWIG-2.0-DIPD; 2.0_1X4_90
C1, C4: 10uF; C0805K
C2, C6, C7: 0.1uF; C0805K
C3, C11: 0.1uF; 0402-CAP
C9: 10uF; EIA3216
DBG_L: BLUE; CHIPLED_0805
DS3231: DS3231/SO; SO16W
FRAME1: FRAME-LEDGER; CREATIVE_COMMONS
FT232RL: FT232RL-BASICSSOP; SSOP28DB
GPS: TWIG-2.0-DIPD; 2.0_1X4_90
ISP: AVR_SPI_PRG_6PTH; 2X3
J1: 22-05-7028-02; 7395-02
MICROSD: USD-SOCKETNEW; MICRO-SD-SOCKET-PP
OSC: 8.00MHZ SMD; RESONATOR-SMD
PWR: RED; CHIPLED_0805
R1, R3, R6, R7: 1K; R0805
R2, R5, R11: 1k; R0805
R8, R10, R13, R16: 10k; R0805
R14: 39.7k; R0805
R15: 3.3k; R0805
RX: GREEN; CHIPLED_0805
S1: SWITCH-MOMENTARY-2-SMD-1101NE; TACTILE-SWITCH-1101NE
SD_L: BLUE; CHIPLED_0805
TEMP: MCP9804; MSOP8
TX: RED; CHIPLED_0805
V_IN: MOUNT-PAD-ROUND4.5; 4,5-PAD
V_OUT: MOUNT-PAD-ROUND4.5; 4,5-PAD
X1: USB-MB-H

Connections:
3.3V: ACS711.8 (VCC), AP1117.2 (OUT), AP1117.4 (OUT), ATMEGA1280.10 (VCC), ATMEGA1280.31 (VCC), ATMEGA1280.61 (VCC), ATMEGA1280.80 (VCC), ATMEGA1280.98 (AREF), ATMEGA1280.100 (AVCC), BLE.3, C1.1, C6.1, C7.1, C11.1, DS3231.2 (VCC), FT232RL.17 (3V3OUT), GPS.3, ISP.2, MICROSD.4 (VCC), R3.2, R6.2, R7.2, R8.2, R10.1, R13.1, R16.1, TEMP.8 (VDD)
AUX_CURRENT: ATMEGA1280.87 (PK2(ADC10/PCINT18))
AUX_FAULT: ATMEGA1280.75 ((AD3)PA3)
BT_RX: ATMEGA1280.64 (PJ1(TXD3/PCINT10)), BLE.2
BT_TX: ATMEGA1280.63 (PJ0(RXD3/PCINT9)), BLE.1
COMM_RX: ATMEGA1280.46 ((TXD1/INT3)PD3), BANCO.2
COMM_TX: ATMEGA1280.45 ((RXD1/INT2)PD2), BANCO.1
CS_SD: ATMEGA1280.50 ((T0)PD7), MICROSD.2 (CS)
DTR: C2.2, FT232RL.2 (DTR)
GND: ACS711.5 (GND), AP1117.1 (GND), ATMEGA1280.11 (GND), ATMEGA1280.32 (GND), ATMEGA1280.62 (GND), ATMEGA1280.81 (GND), ATMEGA1280.99 (GND), BANCO.4, BAT.-, BLE.4, C1.2, C3.2, C4.2, C6.2, C7.2, C9.C (-), C11.2, DBG_L.C, DS3231.5 (NC), DS3231.6 (NC1), DS3231.7 (NC2), DS3231.8 (NC3), DS3231.9 (NC4), DS3231.10 (NC5), DS3231.11 (NC6), DS3231.12 (NC7), DS3231.13 (GND), FT232RL.7 (GND1), FT232RL.11 (CTS), FT232RL.18 (GND2), FT232RL.21 (GND3), FT232RL.25 (AGND), FT232RL.26 (TEST), GPS.4, ISP.6, J1.1, MICROSD.6 (GND), MICROSD.GND1 (SHIELD), MICROSD.GND3 (SHIELD), OSC.2, PWR.C, R15.1, S1.P$1 (1), SD_L.C, TEMP.4 (GND), TEMP.5 (A2), TEMP.6 (A1), TEMP.7 (A0), X1.GND
GPS_RX: ATMEGA1280.13 (PH1(TXD2)), GPS.2
GPS_TX: ATMEGA1280.12 (PH0(RXD2)), GPS.1
IP+: ACS711.1 (IP+), ACS711.2 (IP+), V_IN.B4,5
IP-: ACS711.3 (IP-), ACS711.4 (IP-), V_OUT.B4,5
MISO: ATMEGA1280.22 ((MISO/PCINT3)PB3), ISP.1, MICROSD.7 (DO)
MOSI: ATMEGA1280.21 ((MOSI/PCINT2)PB2), ISP.4, MICROSD.3 (DI)
unnamed: BAT.+, DS3231.14 (VBAT)
unnamed: ATMEGA1280.34 (XTAL1), OSC.1
unnamed: DBG_L.A, R1.2
unnamed: ATMEGA1280.26 ((OC0A/OC1C/PCINT7)PB7), R1.1
unnamed: FT232RL.1 (TXD), R2.1
unnamed: PWR.A, R3.1
unnamed: FT232RL.5 (RXD), R5.1
unnamed: FT232RL.22 (RXLED), RX.C
unnamed: R7.1, RX.A
unnamed: FT232RL.23 (TXLED), TX.C
unnamed: R6.1, TX.A
unnamed: ATMEGA1280.33 (XTAL2), OSC.3
unnamed: R11.2, SD_L.A
unnamed: ACS711.6 (FAULT), R13.2
RAW: AP1117.3 (IN), BANCO.3, C4.1, J1.2, R14.1
RST: ATMEGA1280.30 (!RESET!), C2.1, ISP.5, R8.1, S1.P$2 (2)
RX_FT232: ATMEGA1280.3 ((TXD0)PE1), R5.2
SCK: ATMEGA1280.20 ((SCK/PCINT1)PB1), ISP.3, MICROSD.5 (SCK), R11.1
SCL: ATMEGA1280.43 ((SCL/INT0)PD0), DS3231.16 (SCL), R10.2, TEMP.2 (SCK)
SDA: ATMEGA1280.44 ((SDA/INT1)PD1), DS3231.15 (SDA), R16.2, TEMP.1 (SDA)
SENSOR_CURRENT: ACS711.7 (VOUT), ATMEGA1280.97 ((ADC0)PF0)
SENSOR_VOLT: ATMEGA1280.96 ((ADC1)PF1), R14.2, R15.2
TX_FT232: ATMEGA1280.2 ((PCINT8/RXD0)PE0), R2.2
USB_D+1: FT232RL.15 (USBDP), X1.D+
USB_D-1: FT232RL.16 (USBDM), X1.D-
VCC1: C3.1, C9.A (+), FT232RL.20 (VCC), X1.VBUS
VCCIO: FT232RL.4 (VCCIO)

Notes on the sheet:
Max Voltage Input: 18VDC
Max Current Output: 1A
Regulator 12V -> 3v3
RTC + Battery
Power sensor
Temperature sensor
FTDI MiniUSB 3v3
MicroSD card
Bank communication
GPS
BLUETOOTH
SCL

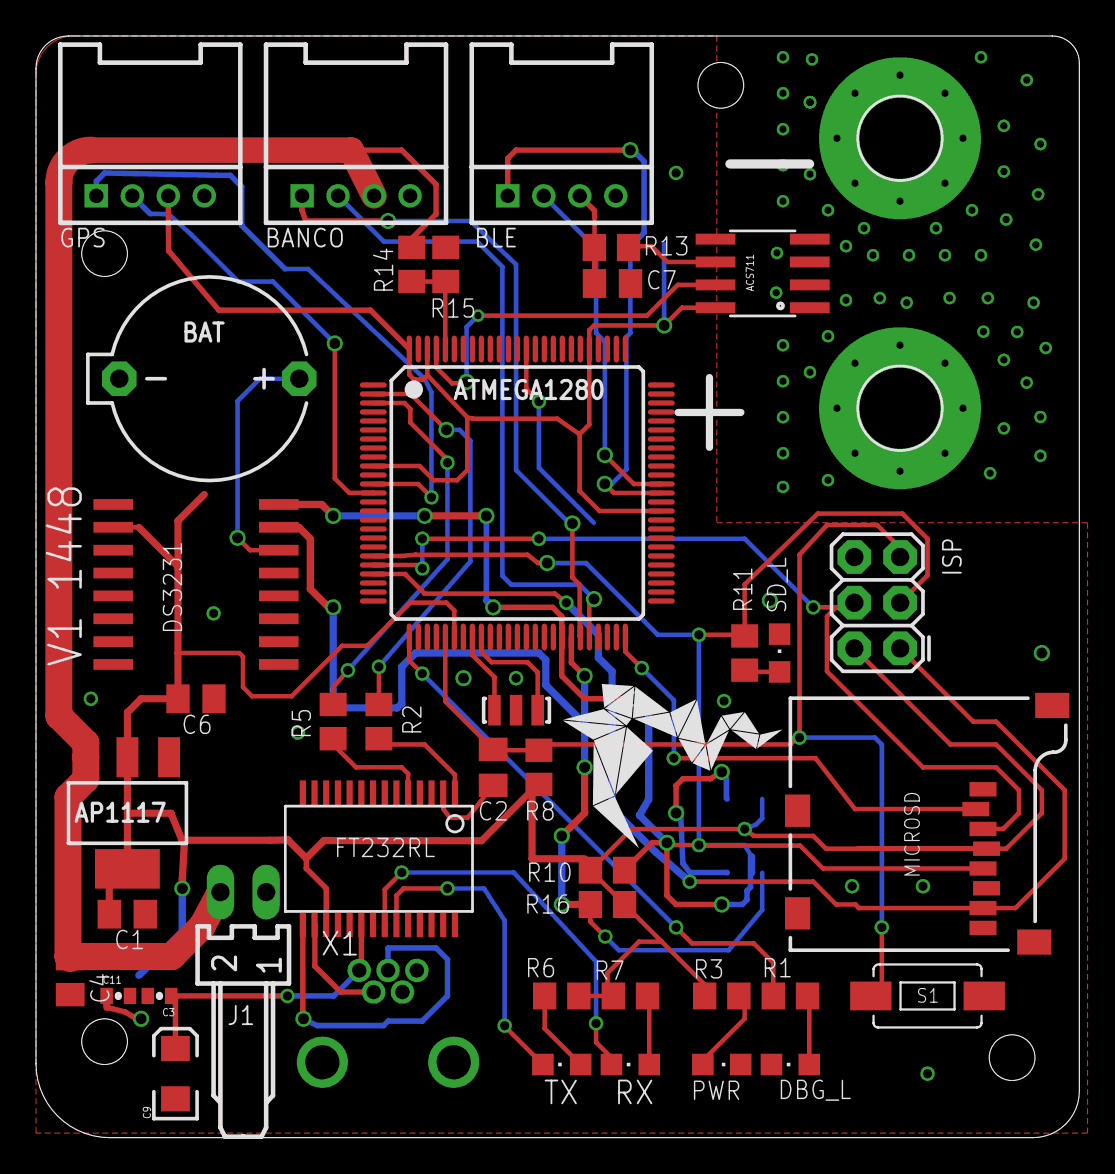
[picture p49: board master-v12_36V.brd from above]

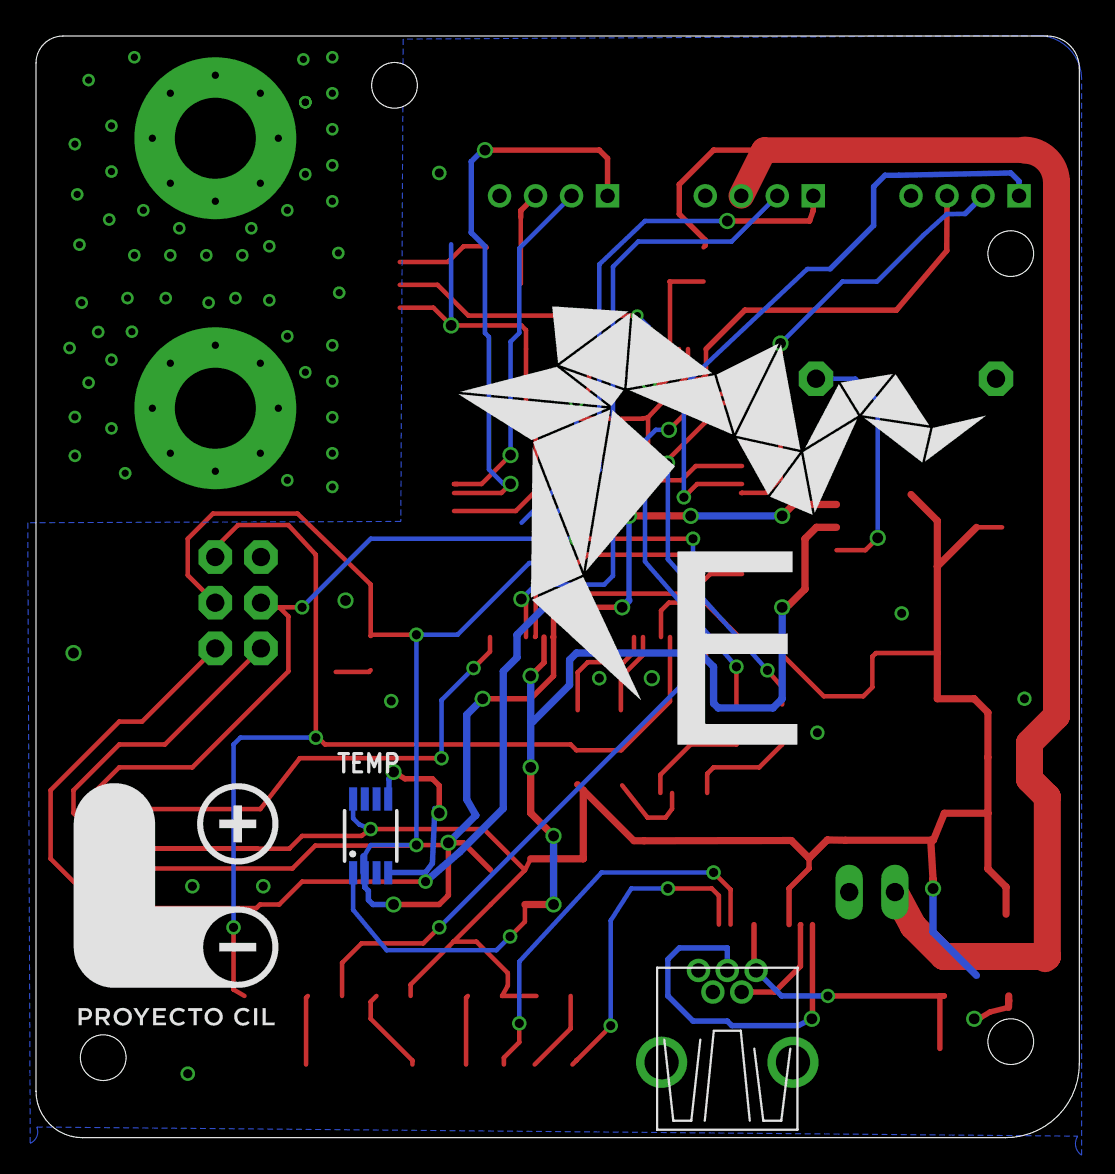
[picture p50: board master-v12_36V.brd from below]

Board: 2 copper layers, 58.0 x 61.2 mm, 48 parts (3 on the bottom side), 40 nets.

Other parts of the board:
U$1: LOGO_CIL
U$2: LOGO_ELIBATT
U$4: LOGO_ELIBATT2
