dpradovillar/Eli-Batt/Hardware/slave/slave.brd

## EAGLE design Hardware/slave/slave.brd (2014-07-30, an earlier design)

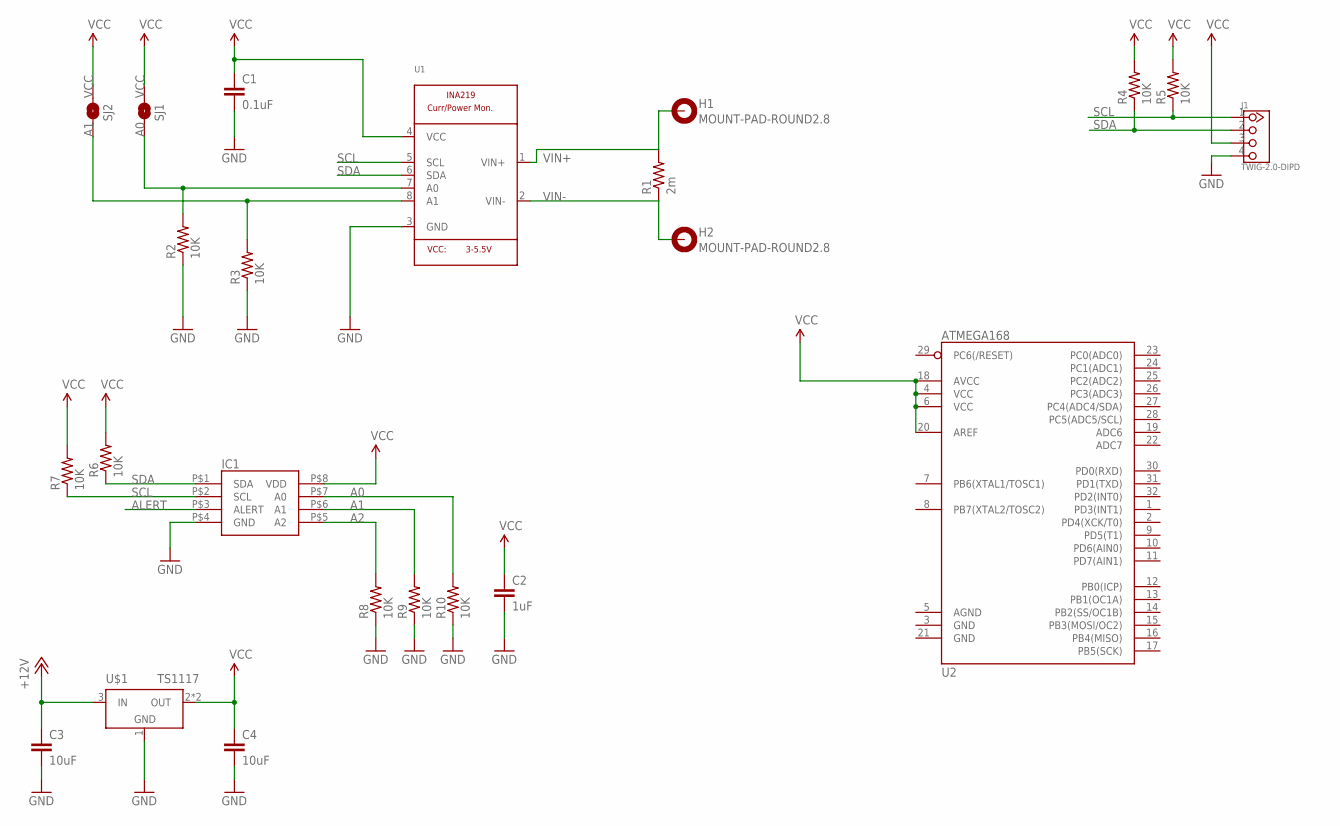
[picture p51: schematic slave.sch]

Parts:
C1: 0.1uF; 0805
C2: 1uF; 0805
C3, C4: 10uF; 0805
H1, H2: MOUNT-PAD-ROUND2.8; 2,8-PAD
IC1: MPC9804; MSOP-8
J1: TWIG-2.0-DIPD; 2.0_1X4_90
R1: 2m; R2512
R2, R3, R4, R5, R6, R7, R8, R9, R10: 10K; 0805
SJ1, SJ2: SOLDERJUMPERNO; SJ_2S-NO
U1: INA219; SOT23-8
U2: ATMEGA168; TQFP32-08
U$1: TS1117; SOT223

Connections:
+12V: C3.1, U$1.3 (IN)
A0: IC1.P$7 (A0), R2.2, R10.2, SJ1.1, U1.7 (A0)
A1: IC1.P$6 (A1), R3.2, R9.2, SJ2.1, U1.8 (A1)
A2: IC1.P$5 (A2), R8.2
ALERT: IC1.P$3 (ALERT)
GND: C1.2, C2.2, C3.2, C4.2, IC1.P$4 (GND), J1.4, R2.1, R3.1, R8.1, R9.1, R10.1, U1.3 (GND), U$1.1 (GND)
SCL: IC1.P$2 (SCL), J1.1, R5.1, R7.1, U1.5 (SCL)
SDA: IC1.P$1 (SDA), J1.2, R4.1, R6.1, U1.6 (SDA)
VCC: C1.1, C2.1, C4.1, IC1.P$8 (VDD), J1.3, R4.2, R5.2, R6.2, R7.2, SJ1.2, SJ2.2, U1.4 (VCC), U2.4 (VCC), U2.6 (VCC), U2.18 (AVCC), U2.20 (AREF), U$1.2 (OUT), U$1.4 (OUT)
VIN+: H1.B2,8, R1.2, U1.1 (VIN+)
VIN-: H2.B2,8, R1.1, U1.2 (VIN-)

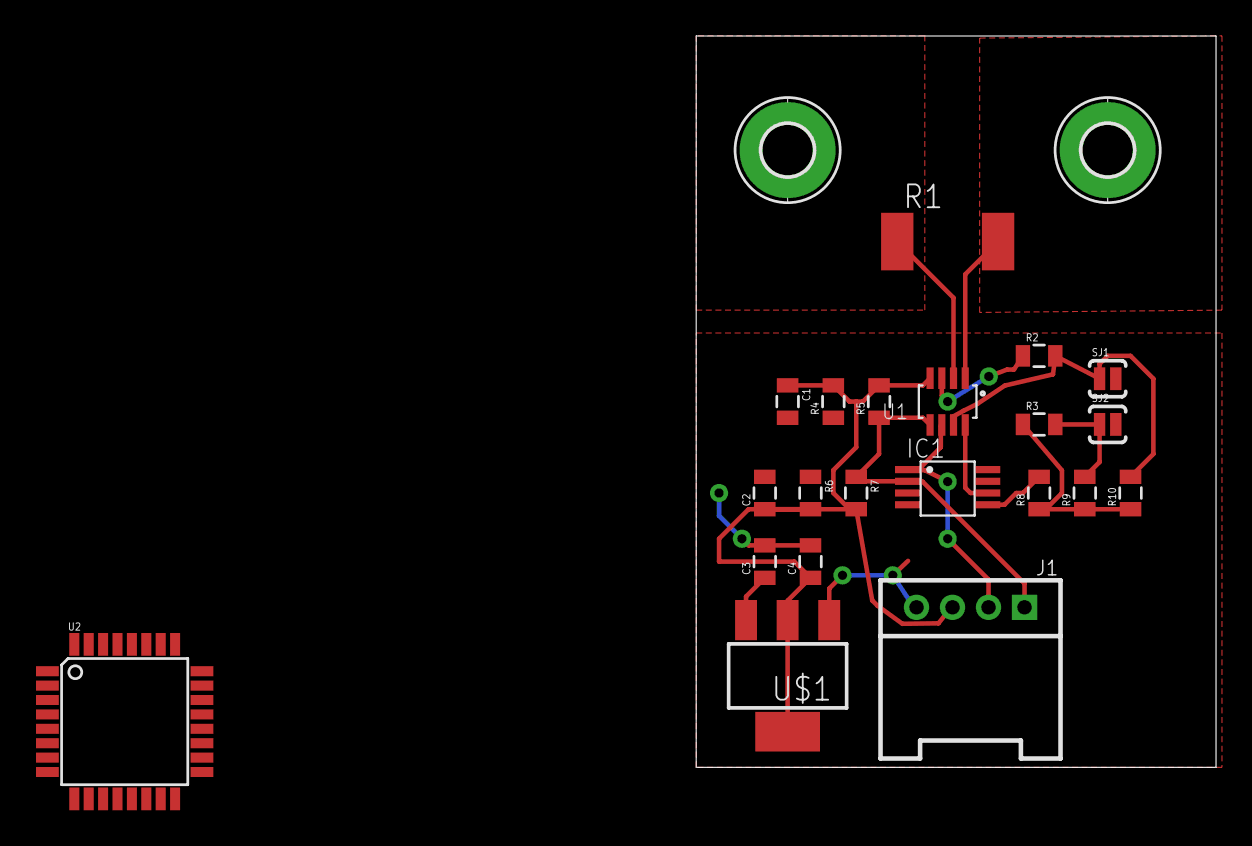
[picture p52: board slave.brd from above]

Board: 2 copper layers, 28.9 x 40.6 mm, 23 parts (0 on the bottom side), 10 nets.
