dpradovillar/Eli-Batt/Hardware/slave/slave-V11.brd

## EAGLE design Hardware/slave/slave-V11.brd (2014-06-27, an earlier design)

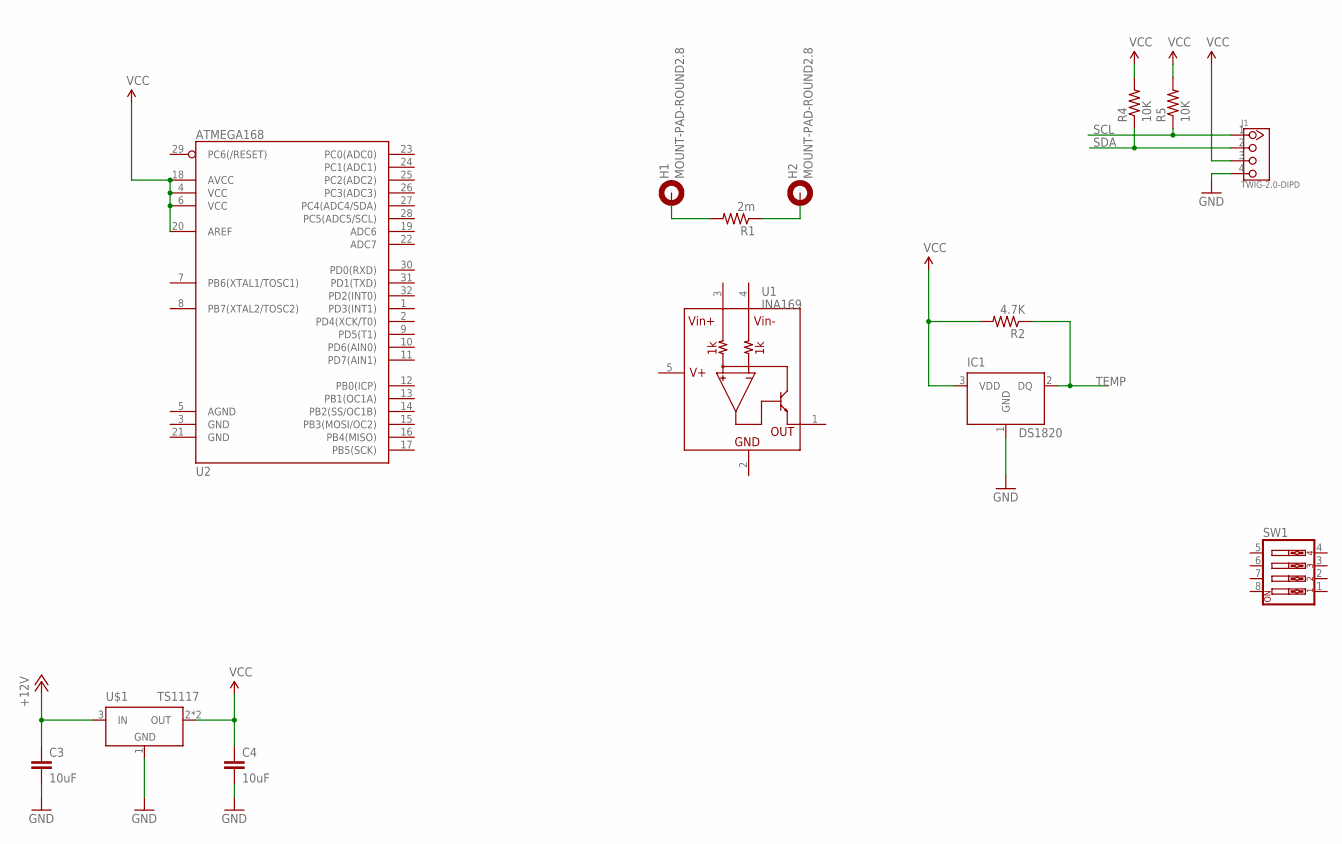
[picture p53: schematic slave-V11.sch]

Parts:
C3, C4: 10uF; 0805
H1, H2: MOUNT-PAD-ROUND2.8; 2,8-PAD
IC1: DS1820; TO-92
J1: TWIG-2.0-DIPD; 2.0_1X4_90
R1: 2m; R2512
R2: 4.7K; 0805
R4, R5: 10K; 0805
SW1: SW_DIP-4; EDG-04
U1: INA169; SOT23-5
U2: ATMEGA168; TQFP32-08
U$1: TS1117; SOT223

Connections:
+12V: C3.1, U$1.3 (IN)
GND: C3.2, C4.2, IC1.1 (GND), J1.4, U$1.1 (GND)
SCL: J1.1, R5.1
SDA: J1.2, R4.1
TEMP: IC1.2 (DQ), R2.1
VCC: C4.1, IC1.3 (VDD), J1.3, R2.2, R4.2, R5.2, U2.4 (VCC), U2.6 (VCC), U2.18 (AVCC), U2.20 (AREF), U$1.2 (OUT), U$1.4 (OUT)
VIN+: H1.B2,8, R1.2
VIN-: H2.B2,8, R1.1

Board: 2 copper layers, 14 parts (0 on the bottom side), 8 nets, no tracks yet.
