dpradovillar/Eli-Batt/Software/BLE-Android/Examples/SimpleControls/src/com/redbear/simplecontrols/SimpleControls.java

package com.redbear.simplecontrols;

import java.util.Timer;
import java.util.TimerTask;

import android.app.Activity;
import android.bluetooth.BluetoothAdapter;
import android.bluetooth.BluetoothDevice;
import android.bluetooth.BluetoothGattCharacteristic;
import android.bluetooth.BluetoothGattService;
import android.bluetooth.BluetoothManager;
import android.content.BroadcastReceiver;
import android.content.ComponentName;
import android.content.Context;
import android.content.Intent;
import android.content.IntentFilter;
import android.content.ServiceConnection;
import android.content.pm.PackageManager;
import android.os.Bundle;
import android.os.IBinder;
import android.util.Log;
import android.view.Gravity;
import android.view.View;
import android.view.View.OnClickListener;
import android.view.Window;
import android.widget.Button;
import android.widget.CompoundButton;
import android.widget.CompoundButton.OnCheckedChangeListener;
import android.widget.SeekBar;
import android.widget.SeekBar.OnSeekBarChangeListener;
import android.widget.TextView;
import android.widget.Toast;
import android.widget.ToggleButton;

public class SimpleControls extends Activity {
    private final static String TAG = SimpleControls.class.getSimpleName();

    private Button connectBtn = null;
    private TextView rssiValue = null;
    private TextView AnalogInValue = null;
    private ToggleButton digitalOutBtn, digitalInBtn, AnalogInBtn;
    private SeekBar servoSeekBar, PWMSeekBar;

    private BluetoothGattCharacteristic characteristicTx = null;
    private RBLService mBluetoothLeService;
    private BluetoothAdapter mBluetoothAdapter;
    private BluetoothDevice mDevice = null;
    private String mDeviceAddress;

    private boolean flag = true;
    private boolean connState = false;
    private boolean scanFlag = false;

    private byte[] data = new byte[3];
    private static final int REQUEST_ENABLE_BT = 1;
    private static final long SCAN_PERIOD = 2000;

    private final ServiceConnection mServiceConnection = new ServiceConnection() {

        @Override
        public void onServiceConnected(ComponentName componentName,
                                       IBinder service) {
            mBluetoothLeService = ((RBLService.LocalBinder) service)
                    .getService();
            if (!mBluetoothLeService.initialize()) {
                Log.e(TAG, "Unable to initialize Bluetooth");
                finish();
            }
        }

        @Override
        public void onServiceDisconnected(ComponentName componentName) {
            mBluetoothLeService = null;
        }
    };

    private final BroadcastReceiver mGattUpdateReceiver = new BroadcastReceiver() {
        @Override
        public void onReceive(Context context, Intent intent) {
            final String action = intent.getAction();

            if (RBLService.ACTION_GATT_DISCONNECTED.equals(action)) {
                Toast.makeText(getApplicationContext(), "Disconnected",
                        Toast.LENGTH_SHORT).show();
                setButtonDisable();
            } else if (RBLService.ACTION_GATT_SERVICES_DISCOVERED
                    .equals(action)) {
                Toast.makeText(getApplicationContext(), "Connected",
                        Toast.LENGTH_SHORT).show();

                getGattService(mBluetoothLeService.getSupportedGattService());
            } else if (RBLService.ACTION_DATA_AVAILABLE.equals(action)) {
                data = intent.getByteArrayExtra(RBLService.EXTRA_DATA);

                readAnalogInValue(data);
            } else if (RBLService.ACTION_GATT_RSSI.equals(action)) {
                displayData(intent.getStringExtra(RBLService.EXTRA_DATA));
            }
        }
    };

    @Override
    protected void onCreate(Bundle savedInstanceState) {
        super.onCreate(savedInstanceState);

        requestWindowFeature(Window.FEATURE_CUSTOM_TITLE);
        setContentView(R.layout.main);
        getWindow().setFeatureInt(Window.FEATURE_CUSTOM_TITLE, R.layout.title);

        rssiValue = (TextView) findViewById(R.id.rssiValue);

        AnalogInValue = (TextView) findViewById(R.id.AIText);

        digitalInBtn = (ToggleButton) findViewById(R.id.DIntBtn);

        connectBtn = (Button) findViewById(R.id.connect);
        connectBtn.setOnClickListener(new OnClickListener() {

            @Override
            public void onClick(View v) {
                if (scanFlag == false) {
                    scanLeDevice();

                    Timer mTimer = new Timer();
                    mTimer.schedule(new TimerTask() {

                        @Override
                        public void run() {
                            if (mDevice != null) {
                                mDeviceAddress = mDevice.getAddress();
                                mBluetoothLeService.connect(mDeviceAddress);
                                scanFlag = true;
                            } else {
                                runOnUiThread(new Runnable() {
                                    public void run() {
                                        Toast toast = Toast
                                                .makeText(
                                                        SimpleControls.this,
                                                        "Couldn't search Ble Shiled device!",
                                                        Toast.LENGTH_SHORT);
                                        toast.setGravity(0, 0, Gravity.CENTER);
                                        toast.show();
                                    }
                                });
                            }
                        }
                    }, SCAN_PERIOD);
                }

                System.out.println(connState);
                if (connState == false) {
                    mBluetoothLeService.connect(mDeviceAddress);
                } else {
                    mBluetoothLeService.disconnect();
                    mBluetoothLeService.close();
                    setButtonDisable();
                }
            }
        });

        digitalOutBtn = (ToggleButton) findViewById(R.id.DOutBtn);
        digitalOutBtn.setOnCheckedChangeListener(new OnCheckedChangeListener() {

            @Override
            public void onCheckedChanged(CompoundButton buttonView,
                                         boolean isChecked) {
                byte buf[] = new byte[]{(byte) 0x01, (byte) 0x00, (byte) 0x00};

                if (isChecked == true)
                    buf[1] = 0x01;
                else
                    buf[1] = 0x00;

                characteristicTx.setValue(buf);
                mBluetoothLeService.writeCharacteristic(characteristicTx);
            }
        });

        AnalogInBtn = (ToggleButton) findViewById(R.id.AnalogInBtn);
        AnalogInBtn.setOnCheckedChangeListener(new OnCheckedChangeListener() {

            @Override
            public void onCheckedChanged(CompoundButton buttonView,
                                         boolean isChecked) {
                byte[] buf = new byte[]{(byte) 0xA0, (byte) 0x00, (byte) 0x00};

                if (isChecked == true)
                    buf[1] = 0x01;
                else
                    buf[1] = 0x00;

                characteristicTx.setValue(buf);
                mBluetoothLeService.writeCharacteristic(characteristicTx);
            }
        });

        servoSeekBar = (SeekBar) findViewById(R.id.ServoSeekBar);
        servoSeekBar.setEnabled(false);
        servoSeekBar.setMax(180);
        servoSeekBar.setOnSeekBarChangeListener(new OnSeekBarChangeListener() {

            @Override
            public void onStopTrackingTouch(SeekBar seekBar) {

            }

            @Override
            public void onStartTrackingTouch(SeekBar seekBar) {

            }

            @Override
            public void onProgressChanged(SeekBar seekBar, int progress,
                                          boolean fromUser) {
                byte[] buf = new byte[]{(byte) 0x03, (byte) 0x00, (byte) 0x00};

                buf[1] = (byte) servoSeekBar.getProgress();

                characteristicTx.setValue(buf);
                mBluetoothLeService.writeCharacteristic(characteristicTx);
            }
        });

        PWMSeekBar = (SeekBar) findViewById(R.id.PWMSeekBar);
        PWMSeekBar.setEnabled(false);
        PWMSeekBar.setMax(255);
        PWMSeekBar.setOnSeekBarChangeListener(new OnSeekBarChangeListener() {

            @Override
            public void onStopTrackingTouch(SeekBar seekBar) {

            }

            @Override
            public void onStartTrackingTouch(SeekBar seekBar) {

            }

            @Override
            public void onProgressChanged(SeekBar seekBar, int progress,
                                          boolean fromUser) {
                byte[] buf = new byte[]{(byte) 0x02, (byte) 0x00, (byte) 0x00};

                buf[1] = (byte) PWMSeekBar.getProgress();

                characteristicTx.setValue(buf);
                mBluetoothLeService.writeCharacteristic(characteristicTx);
            }
        });

        if (!getPackageManager().hasSystemFeature(
                PackageManager.FEATURE_BLUETOOTH_LE)) {
            Toast.makeText(this, "Ble not supported", Toast.LENGTH_SHORT)
                    .show();
            finish();
        }

        final BluetoothManager mBluetoothManager = (BluetoothManager) getSystemService(Context.BLUETOOTH_SERVICE);
        mBluetoothAdapter = mBluetoothManager.getAdapter();
        if (mBluetoothAdapter == null) {
            Toast.makeText(this, "Ble not supported", Toast.LENGTH_SHORT)
                    .show();
            finish();
            return;
        }

        Intent gattServiceIntent = new Intent(SimpleControls.this,
                RBLService.class);
        bindService(gattServiceIntent, mServiceConnection, BIND_AUTO_CREATE);
    }

    @Override
    protected void onResume() {
        super.onResume();

        if (!mBluetoothAdapter.isEnabled()) {
            Intent enableBtIntent = new Intent(
                    BluetoothAdapter.ACTION_REQUEST_ENABLE);
            startActivityForResult(enableBtIntent, REQUEST_ENABLE_BT);
        }

        registerReceiver(mGattUpdateReceiver, makeGattUpdateIntentFilter());
    }

    private void displayData(String data) {
        if (data != null) {
            rssiValue.setText(data);
        }
    }

    private void readAnalogInValue(byte[] data) {
        for (int i = 0; i < data.length; i += 3) {
            if (data[i] == 0x0A) {
                if (data[i + 1] == 0x01)
                    digitalInBtn.setChecked(false);
                else
                    digitalInBtn.setChecked(true);
            } else if (data[i] == 0x0B) {
                int Value;

                Value = ((data[i + 1] << 8) & 0x0000ff00)
                        | (data[i + 2] & 0x000000ff);

                AnalogInValue.setText(Value + "");
            }
        }
    }

    private void setButtonEnable() {
        flag = true;
        connState = true;

        digitalOutBtn.setEnabled(flag);
        AnalogInBtn.setEnabled(flag);
        servoSeekBar.setEnabled(flag);
        PWMSeekBar.setEnabled(flag);
        connectBtn.setText("Disconnect");
    }

    private void setButtonDisable() {
        flag = false;
        connState = false;

        digitalOutBtn.setEnabled(flag);
        AnalogInBtn.setEnabled(flag);
        servoSeekBar.setEnabled(flag);
        PWMSeekBar.setEnabled(flag);
        connectBtn.setText("Connect");
    }

    private void startReadRssi() {
        new Thread() {
            public void run() {

                while (flag) {
                    mBluetoothLeService.readRssi();
                    try {
                        sleep(500);
                    } catch (InterruptedException e) {
                        e.printStackTrace();
                    }
                }
            }

            ;
        }.start();
    }

    private void getGattService(BluetoothGattService gattService) {
        if (gattService == null)
            return;

        setButtonEnable();
        startReadRssi();

        characteristicTx = gattService
                .getCharacteristic(RBLService.UUID_BLE_SHIELD_TX);

        BluetoothGattCharacteristic characteristicRx = gattService
                .getCharacteristic(RBLService.UUID_BLE_SHIELD_RX);
        mBluetoothLeService.setCharacteristicNotification(characteristicRx,
                true);
        mBluetoothLeService.readCharacteristic(characteristicRx);
    }

    private static IntentFilter makeGattUpdateIntentFilter() {
        final IntentFilter intentFilter = new IntentFilter();

        intentFilter.addAction(RBLService.ACTION_GATT_CONNECTED);
        intentFilter.addAction(RBLService.ACTION_GATT_DISCONNECTED);
        intentFilter.addAction(RBLService.ACTION_GATT_SERVICES_DISCOVERED);
        intentFilter.addAction(RBLService.ACTION_DATA_AVAILABLE);
        intentFilter.addAction(RBLService.ACTION_GATT_RSSI);

        return intentFilter;
    }

    private void scanLeDevice() {
        new Thread() {

            @Override
            public void run() {
                mBluetoothAdapter.startLeScan(mLeScanCallback);

                try {
                    Thread.sleep(SCAN_PERIOD);
                } catch (InterruptedException e) {
                    e.printStackTrace();
                }

                mBluetoothAdapter.stopLeScan(mLeScanCallback);
            }
        }.start();
    }

    private BluetoothAdapter.LeScanCallback mLeScanCallback = new BluetoothAdapter.LeScanCallback() {

        @Override
        public void onLeScan(final BluetoothDevice device, final int rssi,
                             byte[] scanRecord) {
            runOnUiThread(new Runnable() {
                @Override
                public void run() {
                    if (device != null) {
                        if (device.getName().contains("Shield")
                                || device.getName().contains("Biscuit")) {
                            mDevice = device;
                        }
                    }
                }
            });
        }
    };

    @Override
    protected void onStop() {
        super.onStop();

        flag = false;

        unregisterReceiver(mGattUpdateReceiver);
    }

    @Override
    protected void onDestroy() {
        super.onDestroy();

        if (mServiceConnection != null)
            unbindService(mServiceConnection);
    }

    @Override
    protected void onActivityResult(int requestCode, int resultCode, Intent data) {
        // User chose not to enable Bluetooth.
        if (requestCode == REQUEST_ENABLE_BT
                && resultCode == Activity.RESULT_CANCELED) {
            finish();
            return;
        }

        super.onActivityResult(requestCode, resultCode, data);
    }
}
