dpradovillar/Eli-Batt/Firmware/pruebas/one_wire_address_finder/one_wire_address_finder.ino

#include <elibatt_config.h>

#include <Arduino.h>
#include <ArduinoSoftwareSerial.h>
#include <Adafruit_GPS.h>
#include <I2cInput.h>
#include <SPI.h>
#include <AdafruitSD.h>
#include <Cmd.h>
#include <OneWireInput.h>
#include <AnalogInput.h>
#include <Arduino.h>
#include <EEPROM.h>
#include <EepromWriter.h>
#include <Wire.h>
#include <Endpoint.h>
#include <GpsInput.h>
#include <ParserComm.h>
#include <RtcInput.h>
#include <SdData.h>
#include <MemoryFree.h>
#include <OneWire.h>
#include <SimpleCrc.h>
#include <OneWireInput.h>


// This sketch looks for 1-wire devices and
// prints their addresses (serial number) to
// the UART, in a format that is useful in Arduino sketches
// Tutorial: 
// http://www.hacktronics.com/Tutorials/arduino-1-wire-address-finder.html

#include <OneWire.h>

OneWire  ds(32);  // Connect your 1-wire device to pin 3

void setup(void) {
  Serial.begin(9600);
  discoverOneWireDevices();
}

void discoverOneWireDevices(void) {
  byte i;
  byte present = 0;
  byte data[12];
  byte addr[8];
  
  Serial.print("Looking for 1-Wire devices...\n\r");
  while(ds.search(addr)) {
    Serial.print("\n\rFound \'1-Wire\' device with address:\n\r");
    for( i = 0; i < 8; i++) {
      Serial.print("0x");
      if (addr[i] < 16) {
        Serial.print('0');
      }
      Serial.print(addr[i], HEX);
      if (i < 7) {
        Serial.print(", ");
      }
    }
    if ( OneWire::crc8( addr, 7) != addr[7]) {
        Serial.print("CRC is not valid!\n");
        return;
    }
  }
  Serial.print("\n\r\n\rThat's it.\r\n");
  ds.reset_search();
  return;
}

void loop(void) {
  // nothing to see here
}
