dpradovillar/Eli-Batt/(commit log)

2014-06-12 segundo git
    [slave.brd, slave.sch]
2014-06-12 Primer diseño PCB Slave
2014-06-27 a new master was born
    [OpenLog.brd, OpenLog.sch, slave-V11.brd, slave-V11.sch]
2014-06-27 SD + Atmega1280 + reg5V
    [master-v10.brd, master-v10.sch]
2014-07-01 fix RESET pin
    [master-v10.sch]
2014-07-02 Avanzado diagrama de la parte del ft232.
    [master-v10.sch]
2014-07-02 Conector USBMini
    Es más resistente que el USBmicro mecanicamente. El usb normal exije un
    cable no tan standar
    [Leonardino_parts_list.xls, master-v10.sch]
2014-07-04 todos los componentes V10
    Falta revisar compatibilidad entre modulos y hacer layout
    [master-v10.brd, master-v10.sch]
2014-07-14 arrelado problema del ftdi
    [master-v10.brd, master-v10.sch]
2014-07-14 add sensor eagle lbr
2014-07-14 add grove connector eagle lbr
2014-07-14 avanzado temperatura y otros
    [master-v10.brd, master-v10.sch]
2014-07-15 agregado comunicacion
    [master-v10.brd, master-v10.sch]
2014-07-15 add resonator
    [master-v10.sch]
2014-07-15 12DC Power Connector and 1st layout
    [master-v10.sch]
2014-07-15 agregados pads
    [master-v10.brd, master-v10.sch]
2014-07-15 actualizado brd, y arreglado tamaño de algunos componentes
    [master-v10.brd, master-v10.sch]
2014-07-15 orden estetico a brd + mounting holes
    [master-v10.brd]
2014-07-15 orden en esquematico
    [master-v10.brd, master-v10.sch]
2014-07-15 some trace route
2014-07-16 more traces
    [master-v10.brd, master-v10.sch]
2014-07-16 casi todas las pistas
    FALTA!! Revisar que no hayan circulos en circuitos de potencia y agregar
    pistas sensor corriente.
    [master-v10.brd]
2014-07-17 algunos arreglos
    Solo falta pistas del sensor de corriente y algunas tierras
    [master-v10.brd, master-v10.sch]
2014-07-17 archivos temp de forma generica al ignore list
2014-07-17 Corregdas pistas, corregido error en la pila del RTC
    [master-v10.brd, master-v10.sch]
2014-07-17 modelo 3d
    [PCB MASTER.skp, PCB MASTER.stl, master-v10.brd]
2014-07-17 Agrandada pista de corriente
    [master-v10.brd]
2014-07-18 reparado usb, ensanchada linea raw, etc
    [master-v10.brd]
2014-07-18 Ajustado silk Screen
    [master-v10.brd, master-v10.sch]
2014-07-22 nuevo render
    [PCB MASTER.skp, masrter.stl]
2014-07-22 add reset button
    and rounded corners
    [PCB MASTER.skp, master-v10.brd, master-v10.sch]
2014-07-22 release for manufacture
    gerbers with logo and renders
    [PCB MASTER.skp, PCB MASTER.stl, masrter.stl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]
2014-07-23 fix gnd for PWR LED and update gerbers with logos
    [master-v10.brd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]
2014-07-24 gerbers fix
    add current sensor cupper area to the soldermask
    [master-v10.brd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]
2014-07-28 add AUX Current sensor
    [PCB MASTER.skp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]
2014-07-30 Cambiado INA169 por ACS711 Cambiado conector de energia por molex 22-05
    [master-v11.brd, master-v11.sch]
2014-07-30 Revert "."
    This reverts commit 88ed2cc015553062a76e2134231f87feefea0a33.
    [BOM-master-v11.xlsx, slave-V11.brd, slave-V11.sch, slave-v10.brd, slave-v10.sch, slave.brd, slave.sch]
2014-07-31 render
    PCB Black
    [PCB MASTER.skp, master-v11.brd]
2014-08-02 gerbes + BOM
    add more tweaks
    [BOM-master-v11.xlsx, master-v11.brd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]
2014-08-30 Movido a carpeta Hardware, creada carpeta vacia Firmware
    [BOM-master-v11.xlsx, Leonardino_parts_list.xls, PCB MASTER Black.skp, PCB MASTER.skp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]
2014-08-30 Agregado RTCLib y arduino-serial-message-protocol
2014-08-30 Agrega estructura a carpeta Firmware.
    Se colocan librerias en carpeta libraries.
    Se crean dos scripts principales, uno para master y uno para slave.
    Se crea carpeta de pruebas, con los .ino que utilizan las librerias (similar a firmware_master y firmware_slave)
    Falta crear libreria firmware.h que contendra las definiciones de master y slave, para usar en los .ino de firmware.
2014-08-31 Agrega definicion de clases para firmware de master y slave.
    Falta agregar los metodos.
2014-08-31 Agrega librerias utilitarias para construccion de firmware.
    - Agrega EepromId, que maneja los ids unicos escritos en la eeprom de la tarjeta.
    - Agrega SampleCollector, que permite obtener datos y ejecutar acciones a uan frequencia determinada.
    - Agrega SimpleCrc, que permite construir checksums para validar contenidos de datos.
2014-08-31 Re organiza el proyecto con la forma definitiva de trabajar.
    - Se usa camel case para nombre archivos, carpetas y clases.
    - Se actualiza readme.txt con instrucciones para compilar/ejecutar el
    firmware.
    - Se corrige la libreria SampleCollector (ahora funciona).
    - Falta manejar el overflow de uint32_t (despues de 70min de estar
    ejecutandose)
    [prueba1.ino]
2014-09-02 Se inician pruebas de librerias (se usan los Firmware* para este fin).
    - Se mueve SoftwareSerial a libraries (se agrega constructor vacio, por
    conveniencia para Elibatt)
    - Se agrega la nueva libreria DataExchanger para intercambio de mensajes
    entre tarjetas slave, y master/slave.
    - Se agrega libreria DataStream para envio de datos complejos.
    - Se actualiza EepromId.
    - Se actualiza SimpleCrc.
    - Se corrigen rutas de los include de los .cpp de cada libreria.
    - Se agrega libreria Utils para funciones utilitarias.
    - Se agrega test para la libreria EepromId.
    - Se agrega libreria Endpoint como wrapper de las conexiones Serials (para
    hardware y software).
    - Se reemplazan tabs por 4 espacios (f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
    [prueba1.ino, pruebaEepromId.ino]
2014-09-02 Se termina de implementar comunicacion para Elibatt. Faltan pruebas.
    Se completa DataExchanger.
    - Falta incluir mecanismo de timeout.
    - Falta includeir mecanismo de acknowledgement.
    - Corregido multiples bugs.
    - Falta terminar de documentar.
    - Falta manejar errores de funcionamiento (se desconecta un Slave en
    caliente?)
    - Falta depurar pruebaDataExchanger (prueba de comunicacion)
    [pruebaDataExchanger.ino, pruebaEepromId.ino, pruebaEndpoint.ino]
2014-09-02 BOM actualizado + cambio de R en FAULT
    [BOM-master-v11.xlsx, master-v11.brd, master-v11.sch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]
2014-09-05 Se agrega prueba de sensores analogos e i2c (temperatura).
    Se crea libreria I2cInput para manejo de sensores i2c (en particular, el de temperatura).
    Se crea libreria AnalogInput para manejo de sensores analogos (en particular, el de corriente y voltaje).
    Se agrega libreria de Adafruit modificada, dependencia de mcp9808.
2014-09-05 Se agrega software experimental para establecer hora de RTC usando software de escritorio.
    TODO(rene): falta validar parametros, hacerlo mas user friendly, y renombrar clases.
    TODO(rene): falta crear procedimiento de deployment de aplicacion.
2014-09-05 Se agrega version 0.1 compilada para windows. Se agregan DLLs de Qt necesarias para deploy.
2014-09-05 Se agrega proyecto Website y ServoController.
    Website es el sitio web interno j2ee para publicacion de datos y generacion de reportes.
    ServoController es un proyecto de prueba para comunicacion bluetooth-android.
2014-09-07 Agrega libreria para escribir datos a tarjeta SD (falta refactorizar e implementar).
2014-09-08 Se completan clases para escritura en SD.
    Falta volcar datos, de sensores genericos a SD.
    Se corrigen bugs menores y se agrega documentacion.
    TODO(rtapiapincheira): renombrar eepromId y agregar soporte para escribir
    otras variables en la eeprom.
    [pruebaSdSequence.ino, pruebaSdWriter.ino, pruebaUtils.ino]
2014-09-10 Omite archivos de proyecto de Qt.
2014-09-11 Se mejora comunicacion entre tarjetas esclavo/maestro.
    Se agrega software para prueba de GPS.
    Se agrega libreria Debugger para crear traza de logs.
    Se renombra EepromId a EepromWriter.
    Se comienza a implementar logica de FirmwareMaster y FirmwareSlave
    (firmwares definitivos).
    Se completa un poco mas software para configuracion de tarjetas.
2014-09-12 Se corrigen errores de include, se trabaja en protocolo master/slave.
    Falta probar.
    Se mejoran los .ino de prueba de firmware master/slave.
    Se mejora .ino de prueba eeprom.
    Se agregan funciones utilitarias.
    Se modifica clase de sensor de temperatura para enviar datos digitales.
    Se corrige el setup de firmware master/slave (no se iniciaban las comms).
    Se incorpora clase debugger en firmware slave.
    [pruebaEepromId.ino, pruebaFirmwareMaster.ino, pruebaFirmwareSlave.ino]
2014-09-18 Trabajo en progreso, comunicacion master/slave. Se mejora interfaz gracica, se agrega soporte para BT.
    - Se agrega libreira AltSoftSerial (dependencia de BLE).
    - Se agrega libreria RedBearLab BLEmini.
    - Se completa interfaz grafica de aplicación Qt (quedan pendientes varias
    funcionalidades).
    - Se agrega release 0.9 de aplicacion Qt para windows.
2014-09-19 Se renombra libreria RBL_BLEMini y se modifica para funcionar con Elibatt.
    Se agrega soporte para tarjeta master (atmega1280).
2014-09-20 Refactoring mayor, que incluye escritura sincronizada de SD.
    - Se borran .ino de Firmware Master/Slave (usar pruebas/pruebaFirmware<Master|Slave>).
    - Se agrega modelo de boards.txt (modificar boards.txt original).
    - Se agrega configuracion de pins y de firmware en elibatt_config.h (ver pin-mapping.pdf).
    - Se quita uso de herencia en clases (problemas de ram en uno, falta revisar uso de ram, mega funciona OK).
    - Se agregan funciones convenientes en Debugger y Utils.
    - Se agrega escritura sincronizada de N slaves en master.
    - Se agregan sensores (temp,curr,volt) en master y slave.
    - Falta factorizar codigo repetido entre master y slave (setup?).
    - Se modifica Mcp9808 para retornar datos invali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
    [pruebaFirmwareMaster.ino, pruebaFirmwareSlave.ino, pruebaRam.ino, pruebaUnix.ino, pruebaUtils.ino]
2014-09-23 Se cambia escritura en SD via comando 's' por temporizador de 1 segundo.
2014-09-23 algunos codigos para prueba
2014-09-28 Trabajo en progreso.
    - Se remueve codigo duplicado en FirmwareMaster/FirmwareSlave.
    - Se agrega clase base Firmware
    - Se reordenan archivos para tener menos librerias, pero con mas clases
    c/u.
2014-09-28 Trabajo en progreso.
    Se refactoriza gran parte de la aplicacion.
    Se avanza en comunicacion master-slave.
2014-09-28 Trabajo en progreso.
    - Se corrigen pruebas.
    [pruebaDataExchangerMaster.ino, pruebaDataExchangerSlave.ino, pruebaEndpoint.ino, pruebaRam.ino, pruebaSdSequence.ino, pruebaSdWriter.ino, pruebaSensors.ino, pruebaUtils.ino]
2014-09-30 Se incluye Aplicacion Celular que corre Unix test.
    Se modifica unix test para operar por el puerto BLE de master.
2014-10-05 Se agrega libreria para comunicacion serial.
2014-10-11 Version estable de comunicacion master-slave-pc.
    Se agrega aplicacion simple de consola que implementa comunicacion.
    Se agrega soporte para rtc (para buses i2c malos, se maneja gracefully).
2014-10-12 Se agrega soporte para GPS.
    Se agrega clase GpsInput.
    Se agregan mensajes para variables de gps, ble y rtc.
    Se agrega libreria GPS de Adafruit.
2014-10-14 Se agrega soporte para GPS y BLE.
    Se modifica firmware master para dividir comunicacion.
    Se modifica app android para recepcion de paquetes binarios.
2014-10-16 fix RTC and Temp wires
    In schematic
    [master-v11.brd, master-v11.sch]
2014-10-18 Actualizacion de app android.
2014-10-20 Versión 1.0 de Elibatt-Console.
2014-10-21 Correcion de console y graph que omite caracteres fuera de rango.
2014-11-25 V12
    corrección Labels y pistas
    [BOM-master-v11.xlsx, Stock de materiales.xlsx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]
2014-12-18 BOM Master V12 + gerbers
    [BOM_master-v12.xlsx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]
2015-03-27 V12
    V12 de Master y slave, con gerbers y BOM
    [BOM_Slave-v12.xlsx, Slave-v12.brd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]
2015-04-28 Re incorporacion de librerias en repo GitHub.
2015-04-28 Refactoring inicial al codigo.
    - Se mueven metodos para manejo de SD a libreria UnixCmd.
    - Se mueve firmware a libreria V2Libs.
    - Se agrega documentacion y cambios menores.
2015-04-30 Corrección menor que permite usar BLE.
2015-04-30 Correcciones varias.
    - Mejora formateo de fechas/horas.
    - Agrega prueba aislada de modulo BLE.
    - Corrige detalles en prueba aislada de GPS.
    - Corrige detalles menores en prueba aislada de RTC.
    - Corrige detalles menores en prueba aislada de SD.
    - Agrega prueba aislada de sensor de temperatura.
    [pruebaBle.ino, pruebaGps.ino, pruebaRtc.ino, pruebaSdWriter.ino, pruebaTemp.ino]
2015-05-04 Actualización de librería de temperatura.
2015-05-04 Correcciones varias.
    - Se agrega soporte para escritura de floats en librería de SdData.
    - Se agregan parametros float para debugeo en estructura GpsStruct (si se necesitan enviar, se puede usar la parte entera/decimal, que son enteros).
    - Se actualiza firmware (V2Libs.h) para usar escritura en SD y RTC.
    - Se renombran métodos, variables y se limpia en general.
    - Se agrega prueba específica para testar SD/Temperatura (combinación conflictiva).
2015-05-04 Trabajo en progreso (don't merge into master). Se actualiza librería de RTC y se crea prueba minima para ejecutar sd+rtc+mcp9808.
    La librería de RTC actualizada desde Adafruit introduce cambios mayores y requiere ser adaptado el código de elibatt.
2015-05-04 Se agrega sketch punto de entrada para librería V2Libs (lógica de firmware).
2015-05-04 Se modifica tiempo de volcado a archivo (cada 15min).
2015-05-05 Agrega nueva librería para uso de RTC (DS3231).
2015-05-05 Modificación de librería OneWire para ser usada en el proyecto.
2015-05-05 Agrega librería de SD de Adafruit (wrapper de sdfat) y modificada para que no crashee con la SD de Arduino.
2015-05-05 Recupera librería de RTC de DS3231 antigua.
2015-05-07 Agrega script para generar proyecto para editar en QtCreator.
2015-05-07 INCOMPLETO. Modifica RtcInput para usar la librería del DT3231 antigua nuevamente.
2015-05-14 Actualiza sketch para asignar ID únicos escritos en eeprom.
2015-05-24 Integra aplicación Android exclusiva para renombramiento de la conexión BLE.
2015-05-24 Cambios y correcciones menores para prueba de nuevos sensores en placa con jumpers.
2015-06-02 Version estable que entrega (temperatura, corriente, voltaje) mediante BLE, sin sd, rtc ni gps.
2015-06-04 Implementada comunicación slave-slave.
    - Los comandos ('T', 'C', 'V') se reciben, responden y propagan a través de la cadena de slaves.
    - Las respuestas recibidas de slaves se retropropagan para alcanzar master.
2015-06-09 Respuesta enviada a aplicación móvil ahora incluye el comando usado (i.e para 'T', retorna "T:22.5\n").
2015-06-09 Corrección del protocolo anterior (se agrega prefijo en respuesta para variables de GPS).
2015-06-09 Agrega test funcional para RTC que usa SPI.
    Falta integrarlo en el firmware.
2015-06-16 Trabajo en progreso. Se implementa la comunicación entre slaves, y entre master/slave.
2015-06-16 Integración inicial de sensores RTC con SPI y DS1820.
2015-06-16 Terminada comunicación slave-slave y master-slave.
    Falta: integracion de sensores.
2015-06-18 Prueba sensor de temperatura dallas ds18B20
2015-06-18 Quita informacion de debug al partir firmware, para evitar posible ruido inicial.
2015-06-25 Sensores integrados OK, sd funcionando OK, archivos en SD se llaman yyyyMMdd.CSV.
2015-06-30 Agrega comando R0/R1 para apagar/prender relé en el pin digital 36 (el led en el pin 13 reflejará el estado high/low de este pin).
2015-07-02 Actualiza aplicación de consola para listar conexiones BLE antes de comunicarse.
2015-07-02 Se agrega proyecto para control de luces via android. Se agrega flag de status en calculo de variables promedio en master. Se re ajustan valores de divisor de voltaje en master.
2015-07-09 Correcciones menores a manejo de relé e interfaz gráfica de aplicación móvil.
2015-07-09 Agrega set de hora/fecha via comando (SDATEyyyyMMddThhmmss y GDATE).
2015-07-14 Corrección en captura de temperatura y estado del relé.
2015-07-24 Agrega versión inicial de Elibatt-Viewer.
2015-07-24 Agrega datos CSV de prueba.
    [20150714.CSV, 20150720.CSV]
2015-07-30 Agrega marco de primer grafico.
2015-07-30 Se termina la generación de reporte simple a partir de datos de SD.
2015-07-30 Correcciones menores a procesamiento de datos.
    Falta agregar indicador de progreso al procesar archivos (util para grandes cantidades de archivos).
2015-07-30 Agrega ejemplo de reporte PDF generado por la aplicacion.
2015-07-30 Se agrega indicador de progreso de creación de reporte.
2015-07-30 Se inicia la implementación de envío masivo.
2015-08-14 Agrega lógica de switch según valor análogo (luces de emergencia).
