dpradovillar/Eli-Batt/(notices)

Notices in the files:
parts and their libraries:
SparkFun-Passives: Licensing: Creative Commons ShareAlike 4.0 International - https://creativecommons.org/licenses/by-sa/4.0
atmel-avr: Copyright (C) 2008, Bob Starr
SparkFun-Aesthetics: Released under the Creative Commons Attribution Share-Alike 4.0 License
